w531t4/panelith/ulx3s.kicad_pcb

## KiCad design ulx3s.kicad_pcb (2026-05-25)

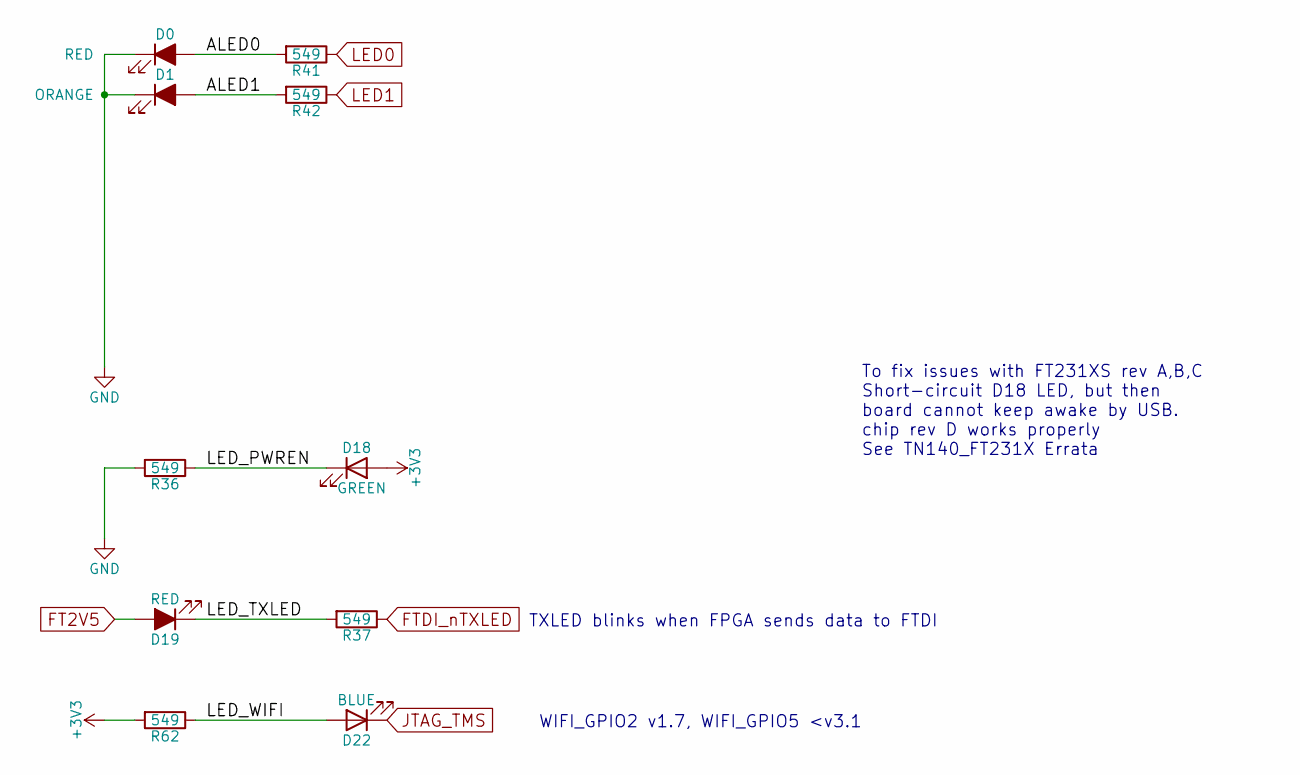
[picture p1: schematic blinkey.kicad_sch, ULX3S]

Parts:
D0: RED; LED_0805_2012Metric; MPN LTST-C170KRKT; Mouser 859-LTST-C170KRKT
D1: ORANGE; LED_0805_2012Metric; MPN LTST-C170KFKT; Mouser 859-LTST-C170KFKT
D18: GREEN; LED_0805_2012Metric; MPN LTST-C170TGKT; Mouser 859-LTST-C170TGKT
D19: RED; LED_0805_2012Metric; MPN LTST-C170KRKT; Mouser_URL www.mouser.com
D22: BLUE; LED_0805_2012Metric; MPN LTST-C170TBKT; Mouser 859-LTST-C170TBKT
R36, R37, R41, R42, R62: 549; R_0603_1608Metric; MPN 13-AC0603FR-07549RLCT-ND; Digikey 13-AC0603FR-07549RLCT-ND

Connections:
+3V3: D18.2 (A), R62.2; also elsewhere on the board
/blinkey/ALED0: D0.2 (A), R41.2
/blinkey/ALED1: D1.2 (A), R42.2
/blinkey/LED_PWREN: D18.1 (K), R36.1
/blinkey/LED_TXLED: D19.1 (K), R37.2
/blinkey/LED_WIFI: D22.2 (A), R62.1
FT2V5: D19.2 (A); also elsewhere on the board
FTDI_nTXLED: R37.1; also elsewhere on the board
GND: D0.1 (K), D1.1 (K), R36.2; also elsewhere on the board
JTAG_TMS: D22.1 (K); also elsewhere on the board
LED0: R41.1; also elsewhere on the board
LED1: R42.1; also elsewhere on the board

Notes on the sheet:
To fix issues with FT231XS rev A,B,C Short-circuit D18 LED, but then board cannot keep awake by USB. chip rev D works properly See TN140_FT231X Errata
TXLED blinks when FPGA sends data to FTDI
WIFI_GPIO2 v1.7, WIFI_GPIO5 <v3.1

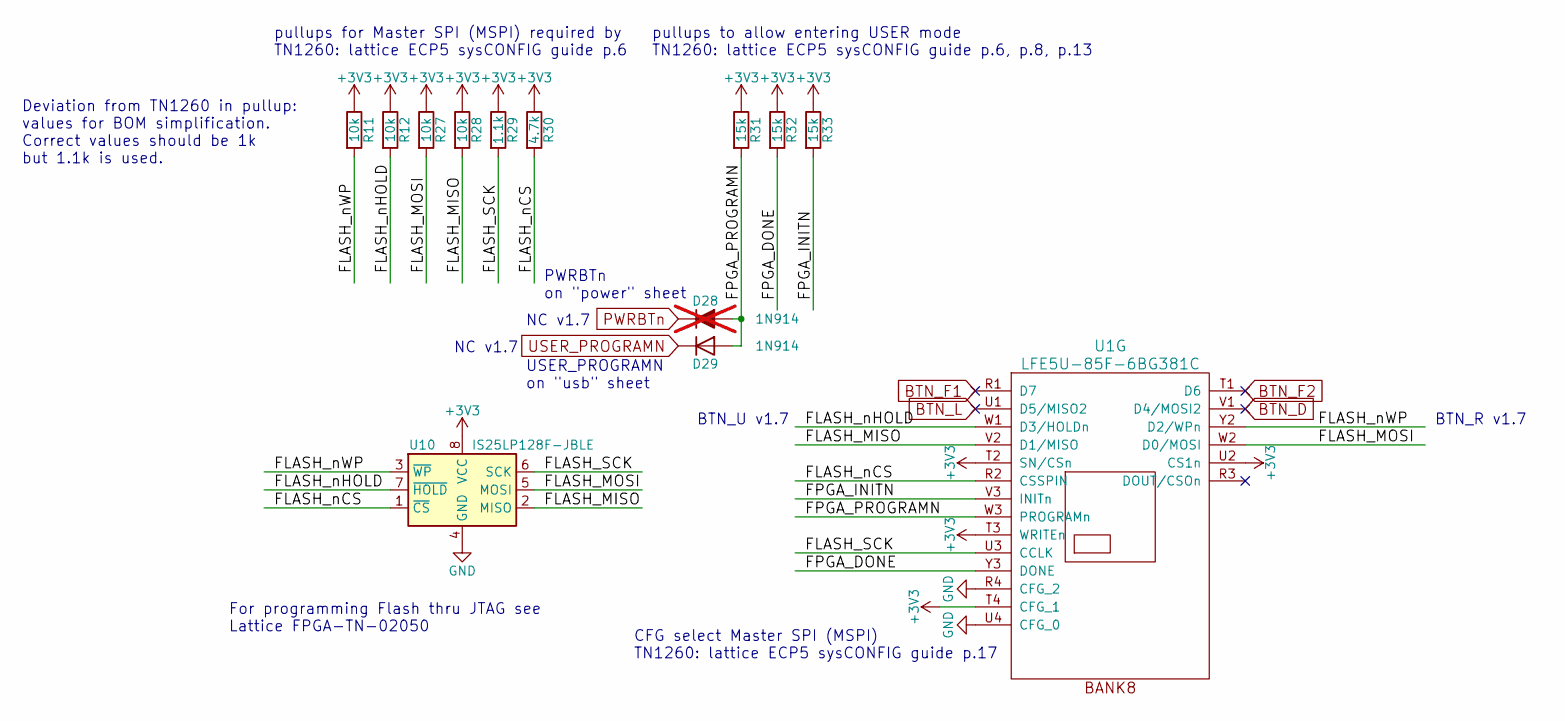
[picture p2: schematic flash.kicad_sch, ULX3S]

Parts:
D28: 1N914; D_SOD-323_HandSoldering; MPN 1N4148WS; Digike_y 1N4148WXTPMSCT-ND; not fitted
D29: 1N914; D_SOD-323_HandSoldering; MPN 1N4148WS; LCSC C258181
R11: 10k; R_0603_1608Metric; MPN RC0603FR-0710KL; Mouser 603-RC0603FR-0710KL
R12, R27, R28: 10k; R_0603_1608Metric; MPN RC0603FR-0710KL; LCSC C15401
R29: 1.1k; R_0603_1608Metric; MPN 13-AC0603FR-071K1LCT-ND; Digikey 13-AC0603FR-071K1LCT-ND
R30: 4.7k; R_0603_1608Metric; MPN 603-RC0603FR-074K7L; LCSC C218056
R31, R32, R33: 15k; R_0603_1608Metric; MPN RC0603FR-0715KL; LCSC C217750
U1: LFE5U-85F-6BG381C; BGA-381_pitch0.8mm_dia0.4mm; MPN LFE5U-85F-6BG381C; LCSC C446029
U10: IS25LP128F-JBLE; SOA008-150-208mil; MPN IS25LP128F-JBLE; Mouser 454-W25Q128JVSIMTR

Connections:
+3V3: R11.1, R12.1, R27.1, R28.1, R29.1, R30.1, R31.1, R32.1, R33.1, U1.T2 (SN/CSn), U1.T3 (WRITEn), U1.T4 (CFG_1), U1.U2 (CS1n), U10.8 (VCC); also elsewhere on the board
/flash/FLASH_MISO: R28.2, U1.V2 (D1/MISO), U10.2 (MISO)
/flash/FLASH_MOSI: R27.2, U1.W2 (D0/MOSI), U10.5 (MOSI)
/flash/FLASH_SCK: R29.2, U1.U3 (CCLK), U10.6 (SCK)
/flash/FLASH_nCS: R30.2, U1.R2 (CSSPIN), U10.1 (~CS)
/flash/FLASH_nHOLD: R12.2, U1.W1 (D3/HOLDn), U10.7 (~HOLD)
/flash/FLASH_nWP: R11.2, U1.Y2 (D2/WPn), U10.3 (~WP)
/flash/FPGA_DONE: R32.2, U1.Y3 (DONE)
/flash/FPGA_INITN: R33.2, U1.V3 (INITn)
/flash/FPGA_PROGRAMN: D28.2 (A), D29.2 (A), R31.2, U1.W3 (PROGRAMn)
AUDIO_L0: U1.E4 (PL17A)
AUDIO_L1: U1.D3 (PL17D)
AUDIO_L3: U1.B3 (PL14D)
AUDIO_R0: U1.A3 (PL14C)
AUDIO_R1: U1.B5 (PL11C)
AUDIO_R2: U1.D5 (PL17B)
AUDIO_R3: U1.C5 (PL11D)
AUDIO_V0: U1.H5 (GR_PCLK7_0)
AUDIO_V1: U1.F2 (PCLKT7_0)
AUDIO_V2: U1.F5 (PL20D)
AUDIO_V3: U1.E5 (PL20C)
BTN_D: U1.V1 (D4/MOSI2)
BTN_F1: U1.R1 (D7)
BTN_F2: U1.T1 (D6)
BTN_L: U1.U1 (D5/MISO2)
BTN_PWRn: D28.1 (K), U1.D6 (PT6B); also elsewhere on the board
GN0: U1.C11 (PCLKC0_0); also elsewhere on the board
GN1: U1.A11 (PCLKC0_1); also elsewhere on the board
GN2: U1.B10 (GR_PCLK0_0); also elsewhere on the board
GN3: U1.C10 (PT58B); also elsewhere on the board
GN4: U1.A8 (PT18B); also elsewhere on the board
GN5: U1.B8 (PT15B); also elsewhere on the board
GN6: U1.C7 (PT11B)
GN7: U1.B6 (PT4B); also elsewhere on the board
GN8: U1.A5 (PL11B); also elsewhere on the board
GN9: U1.B1 (PL35B); also elsewhere on the board
GN10: U1.B4 (PL14B); also elsewhere on the board
GN11: U1.E3 (PL20B); also elsewhere on the board
GN12: U1.F3 (PCLKC7_1); also elsewhere on the board
GN13: U1.G5 (PL41B); also elsewhere on the board
GND: U1.R4 (CFG_2), U1.U4 (CFG_0), U10.4 (GND); also elsewhere on the board
GP0: U1.B11 (PCLKT0_0); also elsewhere on the board
GP1: U1.A10 (PCLKT0_1); also elsewhere on the board
GP2: U1.A9 (GR_PCLK0_1); also elsewhere on the board
GP3: U1.B9 (PT58A); also elsewhere on the board
GP4: U1.A7 (PT18A); also elsewhere on the board
GP5: U1.C8 (PT15A); also elsewhere on the board
GP6: U1.C6 (PT11A); also elsewhere on the board
GP7: U1.A6 (PT4A); also elsewhere on the board
GP8: U1.A4 (PL11A); also elsewhere on the board
GP9: U1.A2 (PL35A); also elsewhere on the board
GP10: U1.C4 (PL14A); also elsewhere on the board
GP11: U1.F4 (PL20A); also elsewhere on the board
GP12: U1.G3 (PCLKT7_1); also elsewhere on the board
GP13: U1.H4 (GR_PCLK7_1); also elsewhere on the board
LED0: U1.B2 (VREF1_7); also elsewhere on the board
LED1: U1.C2 (PL35D); also elsewhere on the board
LED3: U1.D2 (PL38C)
LED4: U1.D1 (PL38B)
LED5: U1.E2 (PCLKC7_0)
LED6: U1.E1 (PL38D)
LED7: U1.H3 (PL41D)
SW1: U1.E8 (PT13A)
SW2: U1.D8 (PT13B)
SW3: U1.D7 (PT9B)
SW4: U1.E7 (PT9A)
USER_PROGRAMN: D29.1 (K); also elsewhere on the board
WIFI_GPIO3: U1.C1 (PL38A); also elsewhere on the board
WIFI_GPIO9: U1.C3 (PL17C); also elsewhere on the board
WIFI_GPIO38: U1.E6 (PT6A); also elsewhere on the board
WIFI_GPIO42: U1.E9 (PT20B); also elsewhere on the board

Notes on the sheet:
PWRBTn on "power" sheet
BTN_U v1.7
For programming Flash thru JTAG see Lattice FPGA-TN-02050
NC v1.7
pullups to allow entering USER mode TN1260: lattice ECP5 sysCONFIG guide p.6, p.8, p.13
CFG select Master SPI (MSPI) TN1260: lattice ECP5 sysCONFIG guide p.17
BTN_R v1.7
USER_PROGRAMN on "usb" sheet
Deviation from TN1260 in pullup: values for BOM simplification. Correct values should be 1k but 1.1k is used.
pullups for Master SPI (MSPI) required by TN1260: lattice ECP5 sysCONFIG guide p.6

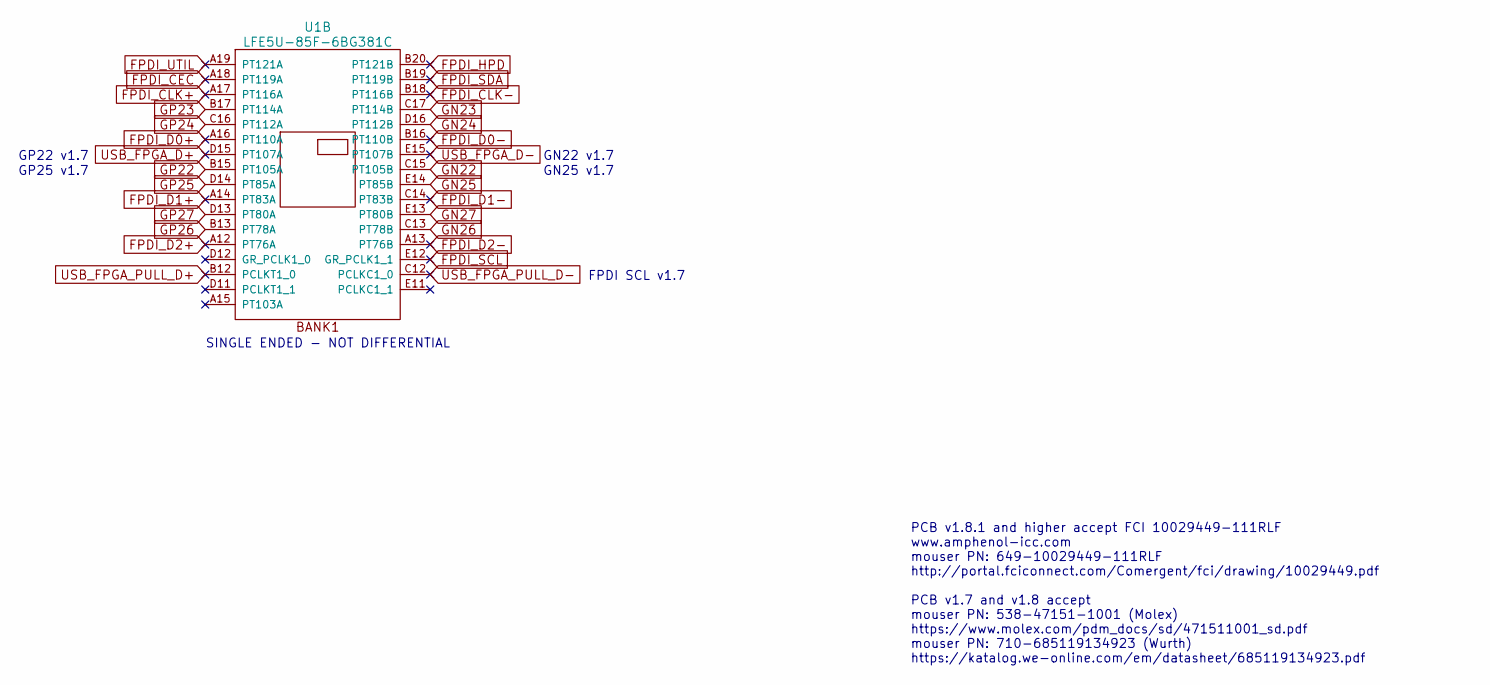
[picture p3: schematic gpdi.kicad_sch, ULX3S]

Parts:
U1: LFE5U-85F-6BG381C; BGA-381_pitch0.8mm_dia0.4mm; MPN LFE5U-85F-6BG381C; Mouser_URL www.mouser.com

Connections:
AUDIO_L0: U1.E4 (PL17A)
AUDIO_L1: U1.D3 (PL17D)
AUDIO_L3: U1.B3 (PL14D)
AUDIO_R0: U1.A3 (PL14C)
AUDIO_R1: U1.B5 (PL11C)
AUDIO_R2: U1.D5 (PL17B)
AUDIO_R3: U1.C5 (PL11D)
AUDIO_V0: U1.H5 (GR_PCLK7_0)
AUDIO_V1: U1.F2 (PCLKT7_0)
AUDIO_V2: U1.F5 (PL20D)
AUDIO_V3: U1.E5 (PL20C)
BTN_PWRn: U1.D6 (PT6B); also elsewhere on the board
FPDI_CEC: U1.A18 (PT119A)
FPDI_CLK+: U1.A17 (PT116A)
FPDI_CLK-: U1.B18 (PT116B)
FPDI_D0+: U1.A16 (PT110A)
FPDI_D0-: U1.B16 (PT110B)
FPDI_D1+: U1.A14 (PT83A)
FPDI_D1-: U1.C14 (PT83B)
FPDI_D2+: U1.A12 (PT76A)
FPDI_D2-: U1.A13 (PT76B)
FPDI_HPD: U1.B20 (PT121B)
FPDI_SCL: U1.E12 (GR_PCLK1_1)
FPDI_SDA: U1.B19 (PT119B)
FPDI_UTIL: U1.A19 (PT121A)
GN0: U1.C11 (PCLKC0_0); also elsewhere on the board
GN1: U1.A11 (PCLKC0_1); also elsewhere on the board
GN2: U1.B10 (GR_PCLK0_0); also elsewhere on the board
GN3: U1.C10 (PT58B); also elsewhere on the board
GN4: U1.A8 (PT18B); also elsewhere on the board
GN5: U1.B8 (PT15B); also elsewhere on the board
GN6: U1.C7 (PT11B)
GN7: U1.B6 (PT4B); also elsewhere on the board
GN8: U1.A5 (PL11B); also elsewhere on the board
GN9: U1.B1 (PL35B); also elsewhere on the board
GN10: U1.B4 (PL14B); also elsewhere on the board
GN11: U1.E3 (PL20B); also elsewhere on the board
GN12: U1.F3 (PCLKC7_1); also elsewhere on the board
GN13: U1.G5 (PL41B); also elsewhere on the board
GN22: U1.C15 (PT105B)
GN23: U1.C17 (PT114B)
GN24: U1.D16 (PT112B)
GN25: U1.E14 (PT85B)
GN26: U1.C13 (PT78B)
GN27: U1.E13 (PT80B)
GP0: U1.B11 (PCLKT0_0); also elsewhere on the board
GP1: U1.A10 (PCLKT0_1); also elsewhere on the board
GP2: U1.A9 (GR_PCLK0_1); also elsewhere on the board
GP3: U1.B9 (PT58A); also elsewhere on the board
GP4: U1.A7 (PT18A); also elsewhere on the board
GP5: U1.C8 (PT15A); also elsewhere on the board
GP6: U1.C6 (PT11A); also elsewhere on the board
GP7: U1.A6 (PT4A); also elsewhere on the board
GP8: U1.A4 (PL11A); also elsewhere on the board
GP9: U1.A2 (PL35A); also elsewhere on the board
GP10: U1.C4 (PL14A); also elsewhere on the board
GP11: U1.F4 (PL20A); also elsewhere on the board
GP12: U1.G3 (PCLKT7_1); also elsewhere on the board
GP13: U1.H4 (GR_PCLK7_1); also elsewhere on the board
GP22: U1.B15 (PT105A)
GP23: U1.B17 (PT114A)
GP24: U1.C16 (PT112A)
GP25: U1.D14 (PT85A)
GP26: U1.B13 (PT78A)
GP27: U1.D13 (PT80A)
LED0: U1.B2 (VREF1_7); also elsewhere on the board
LED1: U1.C2 (PL35D); also elsewhere on the board
LED3: U1.D2 (PL38C)
LED4: U1.D1 (PL38B)
LED5: U1.E2 (PCLKC7_0)
LED6: U1.E1 (PL38D)
LED7: U1.H3 (PL41D)
SW1: U1.E8 (PT13A)
SW2: U1.D8 (PT13B)
SW3: U1.D7 (PT9B)
SW4: U1.E7 (PT9A)
USB_FPGA_D+: U1.D15 (PT107A); also elsewhere on the board
USB_FPGA_D-: U1.E15 (PT107B); also elsewhere on the board
USB_FPGA_PULL_D+: U1.B12 (PCLKT1_0)
USB_FPGA_PULL_D-: U1.C12 (PCLKC1_0)
WIFI_GPIO3: U1.C1 (PL38A); also elsewhere on the board
WIFI_GPIO9: U1.C3 (PL17C); also elsewhere on the board
WIFI_GPIO38: U1.E6 (PT6A); also elsewhere on the board
WIFI_GPIO42: U1.E9 (PT20B); also elsewhere on the board

Notes on the sheet:
PCB v1.8.1 and higher accept FCI 10029449-111RLF www.amphenol-icc.com mouser PN: 649-10029449-111RLF http://portal.fciconnect.com/Comergent/fci/drawing/10029449.pdf PCB v1.7 and v1.8 accept mouser PN: 538-47151-1001 (Molex) https://www.molex.com/pdm_docs/sd/471511001_sd.pdf mouser PN: 710-685119134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
GN22 v1.7
GN25 v1.7
GP25 v1.7
FPDI SCL v1.7
SINGLE ENDED - NOT DIFFERENTIAL
GP22 v1.7

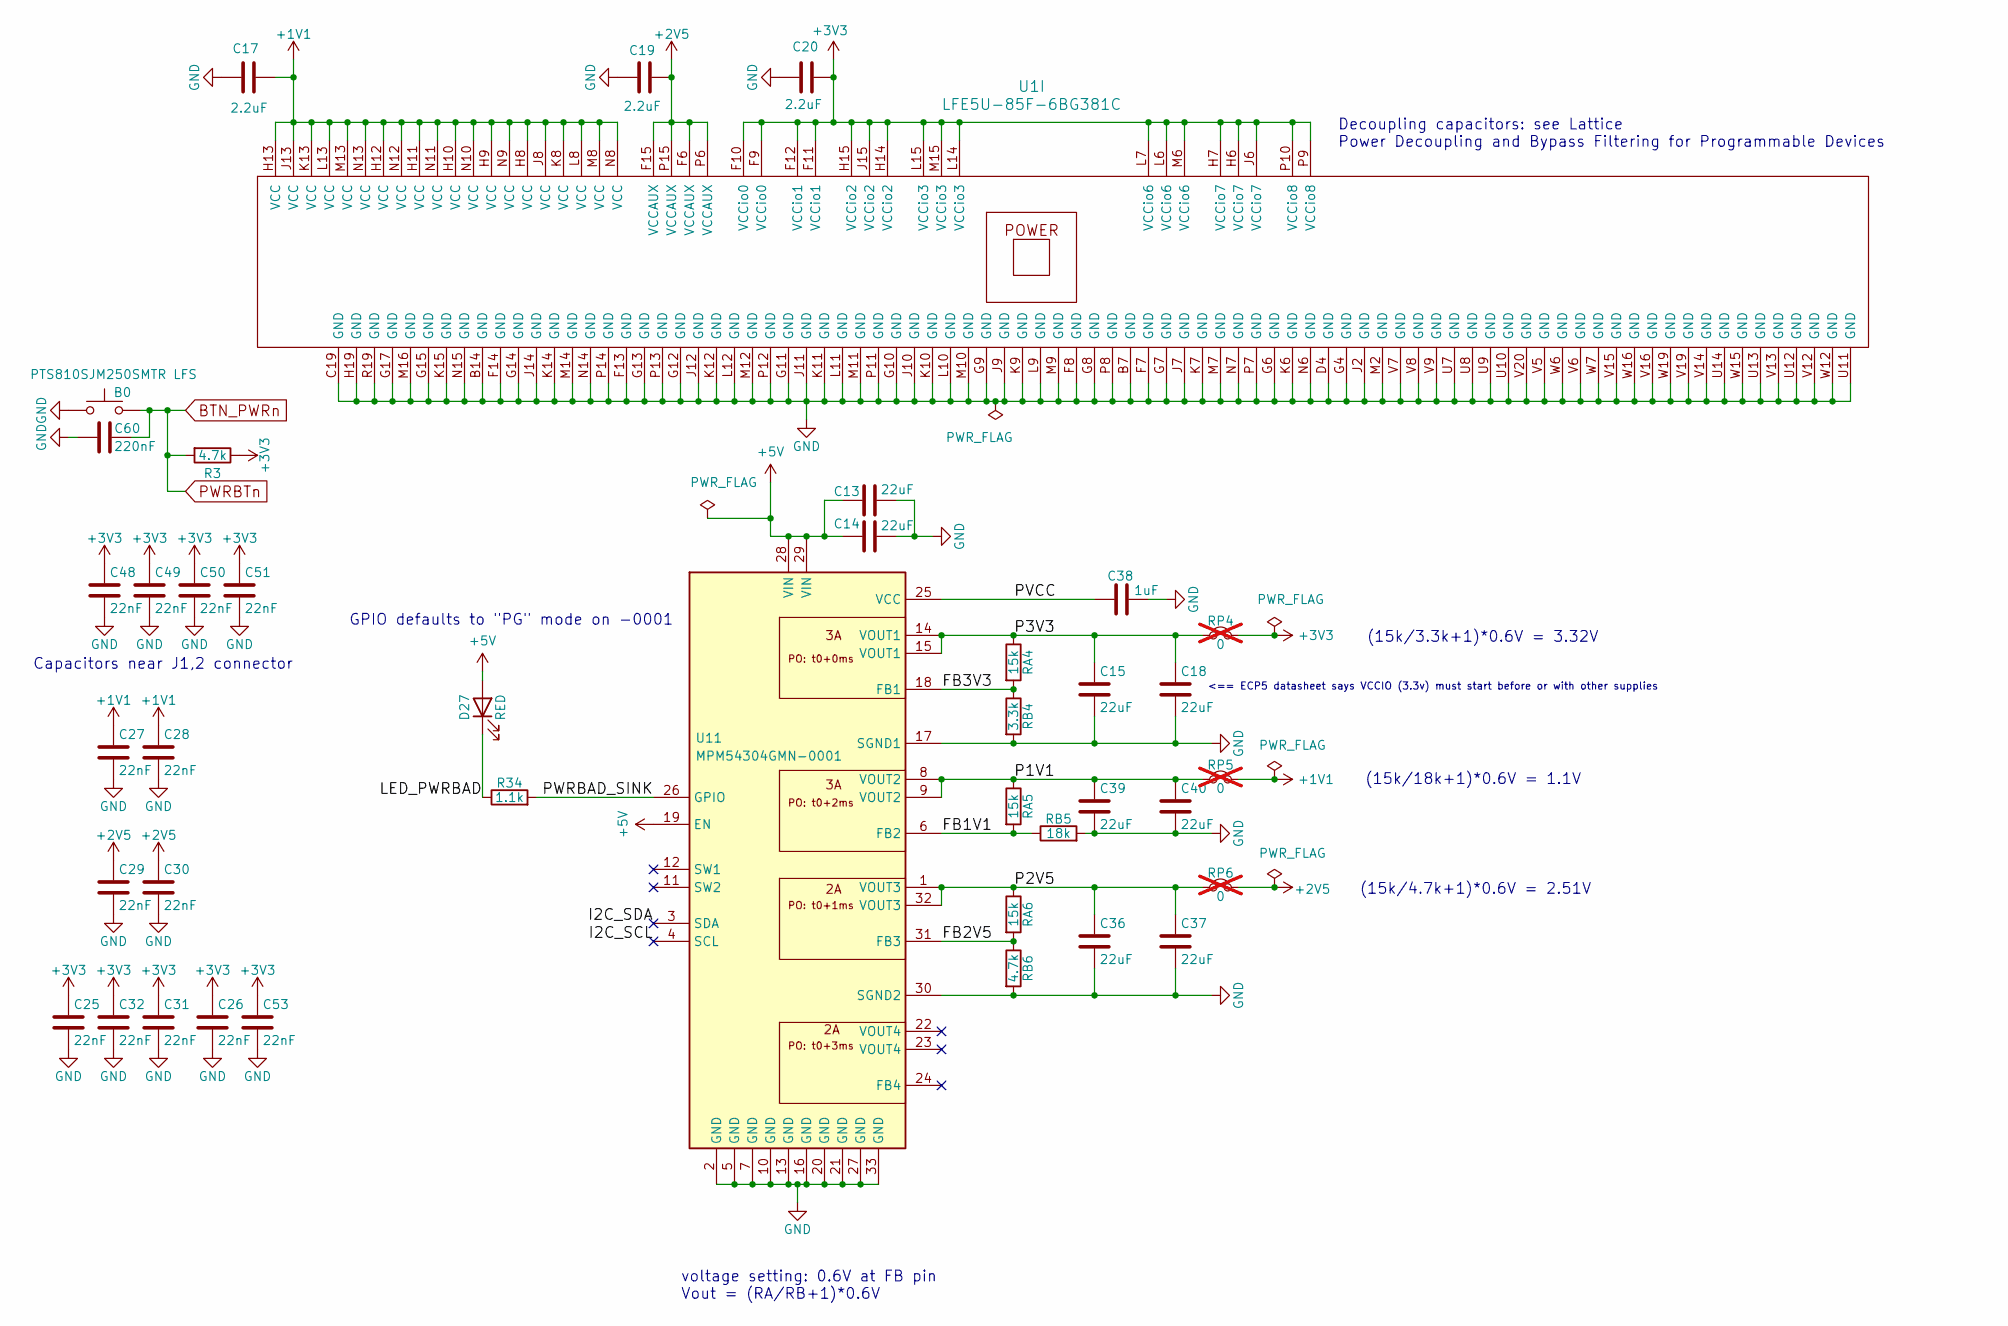
[picture p4: schematic power.kicad_sch, ULX3S]

Parts:
B0: PTS810SJM250SMTR LFS; PTS810_CNK; MPN 611-PTS810SJM250SMTR; Digikey CKN10502CT-ND
C13, C14: 22uF; C_0805_2012Metric; MPN 603-CC805MKX5R6BB226; Mouser 81-GRM21BR61A226ME1L
C15, C18, C36, C37, C39, C40: 22uF; C_0805_2012Metric; MPN 603-CC805MKX5R6BB226; Digikey 311-1900-1-ND
C17, C19, C20: 2.2uF; C_0805_2012Metric; MPN CC0805MRX5R6BB225; LCSC C87995
C25: 22nF; C_0603_1608Metric; MPN CC0603JRX7R8BB223; Mouser 603-CC603KRX7R7BB223
C26, C27, C28, C29, C30, C31, C32, C48, C49, C50, C51, C53: 22nF; C_0603_1608Metric; MPN CC0603JRX7R8BB223; LCSC C107137
C38: 1uF; C_0805_2012Metric; MPN 603-CC805KRX5R6BB105; Digikey 311-3423-1-ND
C60: 220nF; C_0603_1608Metric; MPN CC0603KRX7R8BB224; LCSC C326805
D27: RED; LED_0805_2012Metric; MPN LTST-C170KRKT; Mouser_URL www.mouser.com
R3: 4.7k; R_0603_1608Metric; MPN 603-RC0603FR-074K7L; LCSC C218056
R34: 1.1k; R_0603_1608Metric; MPN 13-AC0603FR-071K1LCT-ND; Digikey 13-AC0603FR-071K1LCT-ND
RA4, RA5, RA6: 15k; R_0603_1608Metric; MPN RC0603FR-0715KL; LCSC C217750
RB4: 3.3k; R_0603_1608Metric; MPN RT0603FRE073K3L; Mouser 603-RC0603FR-073K3L
RB5: 18k; R_0603_1608Metric; MPN RC0603FR-1018KL; Mouser 71-CRCW060318K0FKEAC
RB6: 4.7k; R_0603_1608Metric; MPN 603-RC0603FR-074K7L; LCSC C218056
RP4, RP5, RP6: 0; R_0805_2012Metric_Pad1.20x1.40mm_HandSolder; MPN 603-RC0805JR-070RL; Mouser_URL www.mouser.com; not fitted
U1: LFE5U-85F-6BG381C; BGA-381_pitch0.8mm_dia0.4mm; MPN LFE5U-85F-6BG381C; LCSC C446029
U11: MPM54304GMN-0001; MPM54304GMN0001; Manufacturer_Part_Number MPM54304GMN-0001; Mouser Part Number 946-MPM54304GMN-0001

Connections:
+1V1: C17.2, C27.1, C28.1, RP5.2, U1.H8 (VCC), U1.H9 (VCC), U1.H10 (VCC), U1.H11 (VCC), U1.H12 (VCC), U1.H13 (VCC), U1.J8 (VCC), U1.J13 (VCC), U1.K8 (VCC), U1.K13 (VCC), U1.L8 (VCC), U1.L13 (VCC), U1.M8 (VCC), U1.M13 (VCC), U1.N8 (VCC), U1.N9 (VCC), U1.N10 (VCC), U1.N11 (VCC), U1.N12 (VCC), U1.N13 (VCC)
+2V5: C19.1, C29.1, C30.1, RP6.2, U1.F6 (VCCAUX), U1.F15 (VCCAUX), U1.P6 (VCCAUX), U1.P15 (VCCAUX)
+3V3: C20.2, C25.1, C26.1, C31.1, C32.1, C48.1, C49.1, C50.1, C51.1, C53.1, R3.1, RP4.2, U1.F9 (VCCio0), U1.F10 (VCCio0), U1.F11 (VCCio1), U1.F12 (VCCio1), U1.H6 (VCCio7), U1.H7 (VCCio7), U1.H14 (VCCio2), U1.H15 (VCCio2), U1.J6 (VCCio7), U1.J15 (VCCio2), U1.L6 (VCCio6), U1.L7 (VCCio6), U1.L14 (VCCio3), U1.L15 (VCCio3), U1.M6 (VCCio6), U1.M15 (VCCio3), U1.P9 (VCCio8), U1.P10 (VCCio8); also elsewhere on the board
+5V: C13.1, C14.1, D27.2 (A), U11.19 (EN), U11.28 (VIN), U11.29 (VIN); also elsewhere on the board
/power/FB1V1: RA5.2, RB5.1, U11.6 (FB2)
/power/FB2V5: RA6.2, RB6.1, U11.31 (FB3)
/power/FB3V3: RA4.2, RB4.1, U11.18 (FB1)
/power/I2C_SCL: U11.4 (SCL)
/power/I2C_SDA: U11.3 (SDA)
/power/LED_PWRBAD: D27.1 (K), R34.1
/power/P1V1: C39.1, C40.1, RA5.1, RP5.1, U11.8 (VOUT2), U11.9 (VOUT2)
/power/P2V5: C36.1, C37.1, RA6.1, RP6.1, U11.1 (VOUT3), U11.32 (VOUT3)
/power/P3V3: C15.1, C18.1, RA4.1, RP4.1, U11.14 (VOUT1), U11.15 (VOUT1)
/power/PVCC: C38.1, U11.25 (VCC)
/power/PWRBAD_SINK: R34.2, U11.26 (GPIO)
AUDIO_L0: U1.E4 (PL17A)
AUDIO_L1: U1.D3 (PL17D)
AUDIO_L3: U1.B3 (PL14D)
AUDIO_R0: U1.A3 (PL14C)
AUDIO_R1: U1.B5 (PL11C)
AUDIO_R2: U1.D5 (PL17B)
AUDIO_R3: U1.C5 (PL11D)
AUDIO_V0: U1.H5 (GR_PCLK7_0)
AUDIO_V1: U1.F2 (PCLKT7_0)
AUDIO_V2: U1.F5 (PL20D)
AUDIO_V3: U1.E5 (PL20C)
BTN_PWRn: B0.1, C60.1, R3.2, U1.D6 (PT6B); also elsewhere on the board
GN0: U1.C11 (PCLKC0_0); also elsewhere on the board
GN1: U1.A11 (PCLKC0_1); also elsewhere on the board
GN2: U1.B10 (GR_PCLK0_0); also elsewhere on the board
GN3: U1.C10 (PT58B); also elsewhere on the board
GN4: U1.A8 (PT18B); also elsewhere on the board
GN5: U1.B8 (PT15B); also elsewhere on the board
GN6: U1.C7 (PT11B)
GN7: U1.B6 (PT4B); also elsewhere on the board
GN8: U1.A5 (PL11B); also elsewhere on the board
GN9: U1.B1 (PL35B); also elsewhere on the board
GN10: U1.B4 (PL14B); also elsewhere on the board
GN11: U1.E3 (PL20B); also elsewhere on the board
GN12: U1.F3 (PCLKC7_1); also elsewhere on the board
GN13: U1.G5 (PL41B); also elsewhere on the board
GND: B0.2, C13.2, C14.2, C15.2, C17.1, C18.2, C19.2, C20.1, C25.2, C26.2, C27.2, C28.2, C29.2, C30.2, C31.2, C32.2, C36.2, C37.2, C38.2, C39.2, C40.2, C48.2, C49.2, C50.2, C51.2, C53.2, C60.2, RB4.2, RB5.2, RB6.2, U1.B7 (GND), U1.B14 (GND), U1.C19 (GND), U1.D4 (GND), U1.F7 (GND), U1.F8 (GND), U1.F13 (GND), U1.F14 (GND), U1.G4 (GND), U1.G6 (GND), U1.G7 (GND), U1.G8 (GND), U1.G9 (GND), U1.G10 (GND), U1.G11 (GND), U1.G12 (GND), U1.G13 (GND), U1.G14 (GND), U1.G15 (GND), U1.G17 (GND), U1.H19 (GND), U1.J2 (GND), U1.J7 (GND), U1.J9 (GND), U1.J10 (GND), U1.J11 (GND), U1.J12 (GND), U1.J14 (GND), U1.K6 (GND), U1.K7 (GND), U1.K9 (GND), U1.K10 (GND), U1.K11 (GND), U1.K12 (GND), U1.K14 (GND), U1.K15 (GND), U1.L9 (GND), U1.L10 (GND), U1.L11 (GND), U1.L12 (GND), U1.M2 (GND), U1.M7 (GND), U1.M9 (GND), U1.M10 (GND), U1.M11 (GND), U1.M12 (GND), U1.M14 (GND), U1.M16 (GND), U1.N6 (GND), U1.N7 (GND), U1.N14 (GND), U1.N15 (GND), U1.P7 (GND), U1.P8 (GND), U1.P11 (GND), U1.P12 (GND), U1.P13 (GND), U1.P14 (GND), U1.R19 (GND), U1.U7 (GND), U1.U8 (GND), U1.U9 (GND), U1.U10 (GND), U1.U11 (GND), U1.U12 (GND), U1.U13 (GND), U1.U14 (GND), U1.V5 (GND), U1.V6 (GND), U1.V7 (GND), U1.V8 (GND), U1.V9 (GND), U1.V12 (GND), U1.V13 (GND), U1.V14 (GND), U1.V15 (GND), U1.V16 (GND), U1.V19 (GND), U1.V20 (GND), U1.W6 (GND), U1.W7 (GND), U1.W12 (GND), U1.W15 (GND), U1.W16 (GND), U1.W19 (GND), U11.2 (GND), U11.5 (GND), U11.7 (GND), U11.10 (GND), U11.13 (GND), U11.16 (GND), U11.17 (SGND1), U11.20 (GND), U11.21 (GND), U11.27 (GND), U11.30 (SGND2), U11.33 (GND); also elsewhere on the board
GP0: U1.B11 (PCLKT0_0); also elsewhere on the board
GP1: U1.A10 (PCLKT0_1); also elsewhere on the board
GP2: U1.A9 (GR_PCLK0_1); also elsewhere on the board
GP3: U1.B9 (PT58A); also elsewhere on the board
GP4: U1.A7 (PT18A); also elsewhere on the board
GP5: U1.C8 (PT15A); also elsewhere on the board
GP6: U1.C6 (PT11A); also elsewhere on the board
GP7: U1.A6 (PT4A); also elsewhere on the board
GP8: U1.A4 (PL11A); also elsewhere on the board
GP9: U1.A2 (PL35A); also elsewhere on the board
GP10: U1.C4 (PL14A); also elsewhere on the board
GP11: U1.F4 (PL20A); also elsewhere on the board
GP12: U1.G3 (PCLKT7_1); also elsewhere on the board
GP13: U1.H4 (GR_PCLK7_1); also elsewhere on the board
LED0: U1.B2 (VREF1_7); also elsewhere on the board
LED1: U1.C2 (PL35D); also elsewhere on the board
LED3: U1.D2 (PL38C)
LED4: U1.D1 (PL38B)
LED5: U1.E2 (PCLKC7_0)
LED6: U1.E1 (PL38D)
LED7: U1.H3 (PL41D)
SW1: U1.E8 (PT13A)
SW2: U1.D8 (PT13B)
SW3: U1.D7 (PT9B)
SW4: U1.E7 (PT9A)
WIFI_GPIO3: U1.C1 (PL38A); also elsewhere on the board
WIFI_GPIO9: U1.C3 (PL17C); also elsewhere on the board
WIFI_GPIO38: U1.E6 (PT6A); also elsewhere on the board
WIFI_GPIO42: U1.E9 (PT20B); also elsewhere on the board

Notes on the sheet:
GPIO defaults to "PG" mode on -0001
(15k/4.7k+1)*0.6V = 2.51V
<== ECP5 datasheet says VCCIO (3.3v) must start before or with other supplies
(15k/18k+1)*0.6V = 1.1V
Decoupling capacitors: see Lattice Power Decoupling and Bypass Filtering for Programmable Devices
(15k/3.3k+1)*0.6V = 3.32V
Capacitors near J1,2 connector
voltage setting: 0.6V at FB pin Vout = (RA/RB+1)*0.6V

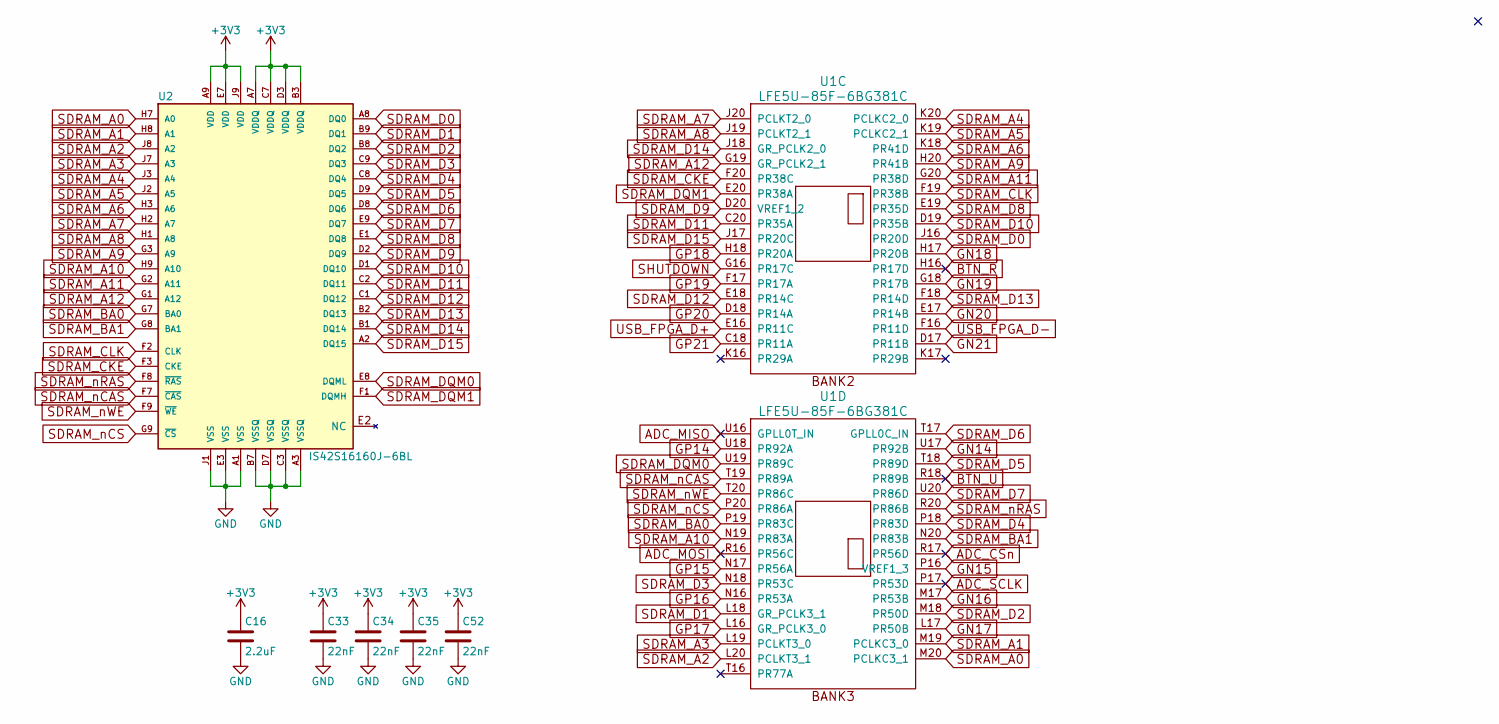
[picture p5: schematic ram.kicad_sch, ULX3S]

Parts:
C16: 2.2uF; C_0805_2012Metric; MPN CC0805MRX5R6BB225; LCSC C87995
C33, C34, C35, C52: 22nF; C_0603_1608Metric; MPN CC0603JRX7R8BB223; LCSC C107137
U1: LFE5U-85F-6BG381C; BGA-381_pitch0.8mm_dia0.4mm; MPN LFE5U-85F-6BG381C; LCSC C446029
U2: IS42S16160J-6BL; BGA54C80P9X9_800X800X120; MPN 870-42S16160J6BL; Mouser 870-IS42S16160G7TLTR

Connections:
+3V3: C16.1, C33.1, C34.1, C35.1, C52.1, U2.A7 (VDDQ), U2.A9 (VDD), U2.B3 (VDDQ), U2.C7 (VDDQ), U2.D3 (VDDQ), U2.E7 (VDD), U2.J9 (VDD); also elsewhere on the board
ADC_CSn: U1.R17 (PR56D)
ADC_MISO: U1.U16 (GPLL0T_IN)
ADC_MOSI: U1.R16 (PR56C)
ADC_SCLK: U1.P17 (PR53D)
AUDIO_L0: U1.E4 (PL17A)
AUDIO_L1: U1.D3 (PL17D)
AUDIO_L3: U1.B3 (PL14D)
AUDIO_R0: U1.A3 (PL14C)
AUDIO_R1: U1.B5 (PL11C)
AUDIO_R2: U1.D5 (PL17B)
AUDIO_R3: U1.C5 (PL11D)
AUDIO_V0: U1.H5 (GR_PCLK7_0)
AUDIO_V1: U1.F2 (PCLKT7_0)
AUDIO_V2: U1.F5 (PL20D)
AUDIO_V3: U1.E5 (PL20C)
BTN_PWRn: U1.D6 (PT6B); also elsewhere on the board
BTN_R: U1.H16 (PR17D)
BTN_U: U1.R18 (PR89B)
GN0: U1.C11 (PCLKC0_0); also elsewhere on the board
GN1: U1.A11 (PCLKC0_1); also elsewhere on the board
GN2: U1.B10 (GR_PCLK0_0); also elsewhere on the board
GN3: U1.C10 (PT58B); also elsewhere on the board
GN4: U1.A8 (PT18B); also elsewhere on the board
GN5: U1.B8 (PT15B); also elsewhere on the board
GN6: U1.C7 (PT11B)
GN7: U1.B6 (PT4B); also elsewhere on the board
GN8: U1.A5 (PL11B); also elsewhere on the board
GN9: U1.B1 (PL35B); also elsewhere on the board
GN10: U1.B4 (PL14B); also elsewhere on the board
GN11: U1.E3 (PL20B); also elsewhere on the board
GN12: U1.F3 (PCLKC7_1); also elsewhere on the board
GN13: U1.G5 (PL41B); also elsewhere on the board
GN14: U1.U17 (PR92B)
GN15: U1.P16 (VREF1_3)
GN16: U1.M17 (PR53B)
GN17: U1.L17 (PR50B)
GN18: U1.H17 (PR20B)
GN19: U1.G18 (PR17B)
GN20: U1.E17 (PR14B)
GN21: U1.D17 (PR11B)
GND: C16.2, C33.2, C34.2, C35.2, C52.2, U2.A1 (VSS), U2.A3 (VSSQ), U2.B7 (VSSQ), U2.C3 (VSSQ), U2.D7 (VSSQ), U2.E3 (VSS), U2.J1 (VSS); also elsewhere on the board
GP0: U1.B11 (PCLKT0_0); also elsewhere on the board
GP1: U1.A10 (PCLKT0_1); also elsewhere on the board
GP2: U1.A9 (GR_PCLK0_1); also elsewhere on the board
GP3: U1.B9 (PT58A); also elsewhere on the board
GP4: U1.A7 (PT18A); also elsewhere on the board
GP5: U1.C8 (PT15A); also elsewhere on the board
GP6: U1.C6 (PT11A); also elsewhere on the board
GP7: U1.A6 (PT4A); also elsewhere on the board
GP8: U1.A4 (PL11A); also elsewhere on the board
GP9: U1.A2 (PL35A); also elsewhere on the board
GP10: U1.C4 (PL14A); also elsewhere on the board
GP11: U1.F4 (PL20A); also elsewhere on the board
GP12: U1.G3 (PCLKT7_1); also elsewhere on the board
GP13: U1.H4 (GR_PCLK7_1); also elsewhere on the board
GP14: U1.U18 (PR92A)
GP15: U1.N17 (PR56A)
GP16: U1.N16 (PR53A)
GP17: U1.L16 (GR_PCLK3_0)
GP18: U1.H18 (PR20A)
GP19: U1.F17 (PR17A)
GP20: U1.D18 (PR14A)
GP21: U1.C18 (PR11A)
LED0: U1.B2 (VREF1_7); also elsewhere on the board
LED1: U1.C2 (PL35D); also elsewhere on the board
LED3: U1.D2 (PL38C)
LED4: U1.D1 (PL38B)
LED5: U1.E2 (PCLKC7_0)
LED6: U1.E1 (PL38D)
LED7: U1.H3 (PL41D)
SDRAM_A0: U1.M20 (PCLKC3_1), U2.H7 (A0)
SDRAM_A1: U1.M19 (PCLKC3_0), U2.H8 (A1)
SDRAM_A2: U1.L20 (PCLKT3_1), U2.J8 (A2)
SDRAM_A3: U1.L19 (PCLKT3_0), U2.J7 (A3)
SDRAM_A4: U1.K20 (PCLKC2_0), U2.J3 (A4)
SDRAM_A5: U1.K19 (PCLKC2_1), U2.J2 (A5)
SDRAM_A6: U1.K18 (PR41D), U2.H3 (A6)
SDRAM_A7: U1.J20 (PCLKT2_0), U2.H2 (A7)
SDRAM_A8: U1.J19 (PCLKT2_1), U2.H1 (A8)
SDRAM_A9: U1.H20 (PR41B), U2.G3 (A9)
SDRAM_A10: U1.N19 (PR83A), U2.H9 (A10)
SDRAM_A11: U1.G20 (PR38D), U2.G2 (A11)
SDRAM_A12: U1.G19 (GR_PCLK2_1), U2.G1 (A12)
SDRAM_BA0: U1.P19 (PR83C), U2.G7 (BA0)
SDRAM_BA1: U1.N20 (PR83B), U2.G8 (BA1)
SDRAM_CKE: U1.F20 (PR38C), U2.F3 (CKE)
SDRAM_CLK: U1.F19 (PR38B), U2.F2 (CLK)
SDRAM_D0: U1.J16 (PR20D), U2.A8 (DQ0)
SDRAM_D1: U1.L18 (GR_PCLK3_1), U2.B9 (DQ1)
SDRAM_D2: U1.M18 (PR50D), U2.B8 (DQ2)
SDRAM_D3: U1.N18 (PR53C), U2.C9 (DQ3)
SDRAM_D4: U1.P18 (PR83D), U2.C8 (DQ4)
SDRAM_D5: U1.T18 (PR89D), U2.D9 (DQ5)
SDRAM_D6: U1.T17 (GPLL0C_IN), U2.D8 (DQ6)
SDRAM_D7: U1.U20 (PR86D), U2.E9 (DQ7)
SDRAM_D8: U1.E19 (PR35D), U2.E1 (DQ8)
SDRAM_D9: U1.D20 (VREF1_2), U2.D2 (DQ9)
SDRAM_D10: U1.D19 (PR35B), U2.D1 (DQ10)
SDRAM_D11: U1.C20 (PR35A), U2.C2 (DQ11)
SDRAM_D12: U1.E18 (PR14C), U2.C1 (DQ12)
SDRAM_D13: U1.F18 (PR14D), U2.B2 (DQ13)
SDRAM_D14: U1.J18 (GR_PCLK2_0), U2.B1 (DQ14)
SDRAM_D15: U1.J17 (PR20C), U2.A2 (DQ15)
SDRAM_DQM0: U1.U19 (PR89C), U2.E8 (DQML)
SDRAM_DQM1: U1.E20 (PR38A), U2.F1 (DQMH)
SDRAM_nCAS: U1.T19 (PR89A), U2.F7 (~CAS)
SDRAM_nCS: U1.P20 (PR86A), U2.G9 (~CS)
SDRAM_nRAS: U1.R20 (PR86B), U2.F8 (~RAS)
SDRAM_nWE: U1.T20 (PR86C), U2.F9 (~WE)
SHUTDOWN: U1.G16 (PR17C)
SW1: U1.E8 (PT13A)
SW2: U1.D8 (PT13B)
SW3: U1.D7 (PT9B)
SW4: U1.E7 (PT9A)
USB_FPGA_D+: U1.E16 (PR11C); also elsewhere on the board
USB_FPGA_D-: U1.F16 (PR11D); also elsewhere on the board
WIFI_GPIO3: U1.C1 (PL38A); also elsewhere on the board
WIFI_GPIO9: U1.C3 (PL17C); also elsewhere on the board
WIFI_GPIO38: U1.E6 (PT6A); also elsewhere on the board
WIFI_GPIO42: U1.E9 (PT20B); also elsewhere on the board

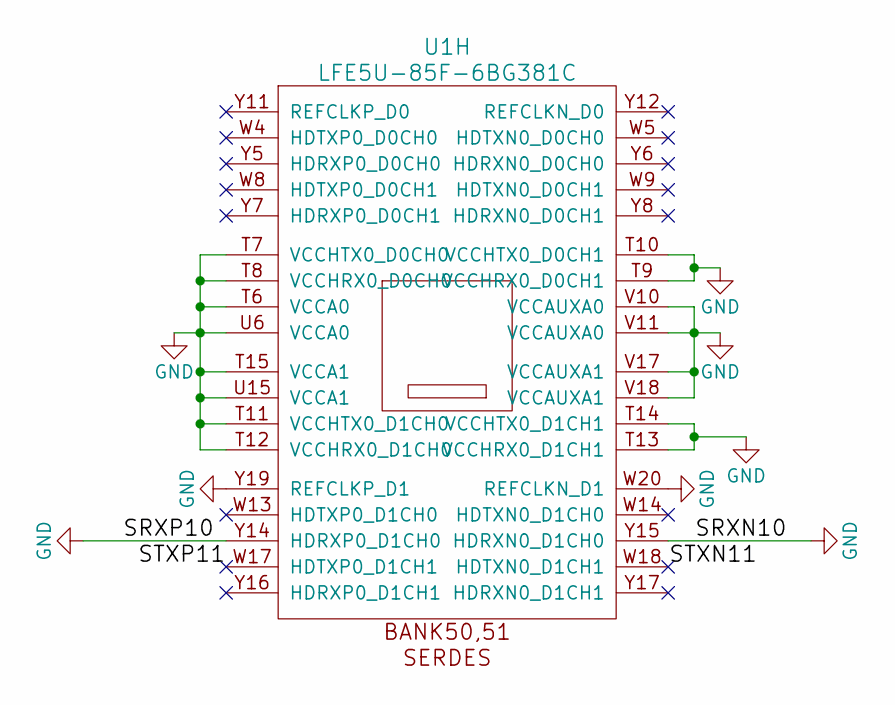
[picture p6: schematic serdes.kicad_sch, ULX3S]

Parts:
U1: LFE5U-85F-6BG381C; BGA-381_pitch0.8mm_dia0.4mm; MPN LFE5U-85F-6BG381C; Mouser 842-LFE5U85F6BG381C

Connections:
/serdes/STXN11: U1.W18 (HDTXN0_D1CH1)
/serdes/STXP11: U1.W17 (HDTXP0_D1CH1)
AUDIO_L0: U1.E4 (PL17A)
AUDIO_L1: U1.D3 (PL17D)
AUDIO_L3: U1.B3 (PL14D)
AUDIO_R0: U1.A3 (PL14C)
AUDIO_R1: U1.B5 (PL11C)
AUDIO_R2: U1.D5 (PL17B)
AUDIO_R3: U1.C5 (PL11D)
AUDIO_V0: U1.H5 (GR_PCLK7_0)
AUDIO_V1: U1.F2 (PCLKT7_0)
AUDIO_V2: U1.F5 (PL20D)
AUDIO_V3: U1.E5 (PL20C)
BTN_PWRn: U1.D6 (PT6B); also elsewhere on the board
GN0: U1.C11 (PCLKC0_0); also elsewhere on the board
GN1: U1.A11 (PCLKC0_1); also elsewhere on the board
GN2: U1.B10 (GR_PCLK0_0); also elsewhere on the board
GN3: U1.C10 (PT58B); also elsewhere on the board
GN4: U1.A8 (PT18B); also elsewhere on the board
GN5: U1.B8 (PT15B); also elsewhere on the board
GN6: U1.C7 (PT11B)
GN7: U1.B6 (PT4B); also elsewhere on the board
GN8: U1.A5 (PL11B); also elsewhere on the board
GN9: U1.B1 (PL35B); also elsewhere on the board
GN10: U1.B4 (PL14B); also elsewhere on the board
GN11: U1.E3 (PL20B); also elsewhere on the board
GN12: U1.F3 (PCLKC7_1); also elsewhere on the board
GN13: U1.G5 (PL41B); also elsewhere on the board
GND: U1.T6 (VCCA0), U1.T7 (VCCHTX0_D0CH0), U1.T8 (VCCHRX0_D0CH0), U1.T9 (VCCHRX0_D0CH1), U1.T10 (VCCHTX0_D0CH1), U1.T11 (VCCHTX0_D1CH0), U1.T12 (VCCHRX0_D1CH0), U1.T13 (VCCHRX0_D1CH1), U1.T14 (VCCHTX0_D1CH1), U1.T15 (VCCA1), U1.U6 (VCCA0), U1.U15 (VCCA1), U1.V10 (VCCAUXA0), U1.V11 (VCCAUXA0), U1.V17 (VCCAUXA1), U1.V18 (VCCAUXA1), U1.W20 (REFCLKN_D1), U1.Y14 (HDRXP0_D1CH0), U1.Y15 (HDRXN0_D1CH0), U1.Y19 (REFCLKP_D1); also elsewhere on the board
GP0: U1.B11 (PCLKT0_0); also elsewhere on the board
GP1: U1.A10 (PCLKT0_1); also elsewhere on the board
GP2: U1.A9 (GR_PCLK0_1); also elsewhere on the board
GP3: U1.B9 (PT58A); also elsewhere on the board
GP4: U1.A7 (PT18A); also elsewhere on the board
GP5: U1.C8 (PT15A); also elsewhere on the board
GP6: U1.C6 (PT11A); also elsewhere on the board
GP7: U1.A6 (PT4A); also elsewhere on the board
GP8: U1.A4 (PL11A); also elsewhere on the board
GP9: U1.A2 (PL35A); also elsewhere on the board
GP10: U1.C4 (PL14A); also elsewhere on the board
GP11: U1.F4 (PL20A); also elsewhere on the board
GP12: U1.G3 (PCLKT7_1); also elsewhere on the board
GP13: U1.H4 (GR_PCLK7_1); also elsewhere on the board
LED0: U1.B2 (VREF1_7); also elsewhere on the board
LED1: U1.C2 (PL35D); also elsewhere on the board
LED3: U1.D2 (PL38C)
LED4: U1.D1 (PL38B)
LED5: U1.E2 (PCLKC7_0)
LED6: U1.E1 (PL38D)
LED7: U1.H3 (PL41D)
SW1: U1.E8 (PT13A)
SW2: U1.D8 (PT13B)
SW3: U1.D7 (PT9B)
SW4: U1.E7 (PT9A)
WIFI_GPIO3: U1.C1 (PL38A); also elsewhere on the board
WIFI_GPIO9: U1.C3 (PL17C); also elsewhere on the board
WIFI_GPIO38: U1.E6 (PT6A); also elsewhere on the board
WIFI_GPIO42: U1.E9 (PT20B); also elsewhere on the board
