w531t4/panelith/ulx3s.kicad_pcb

## KiCad design ulx3s.kicad_pcb (continued)

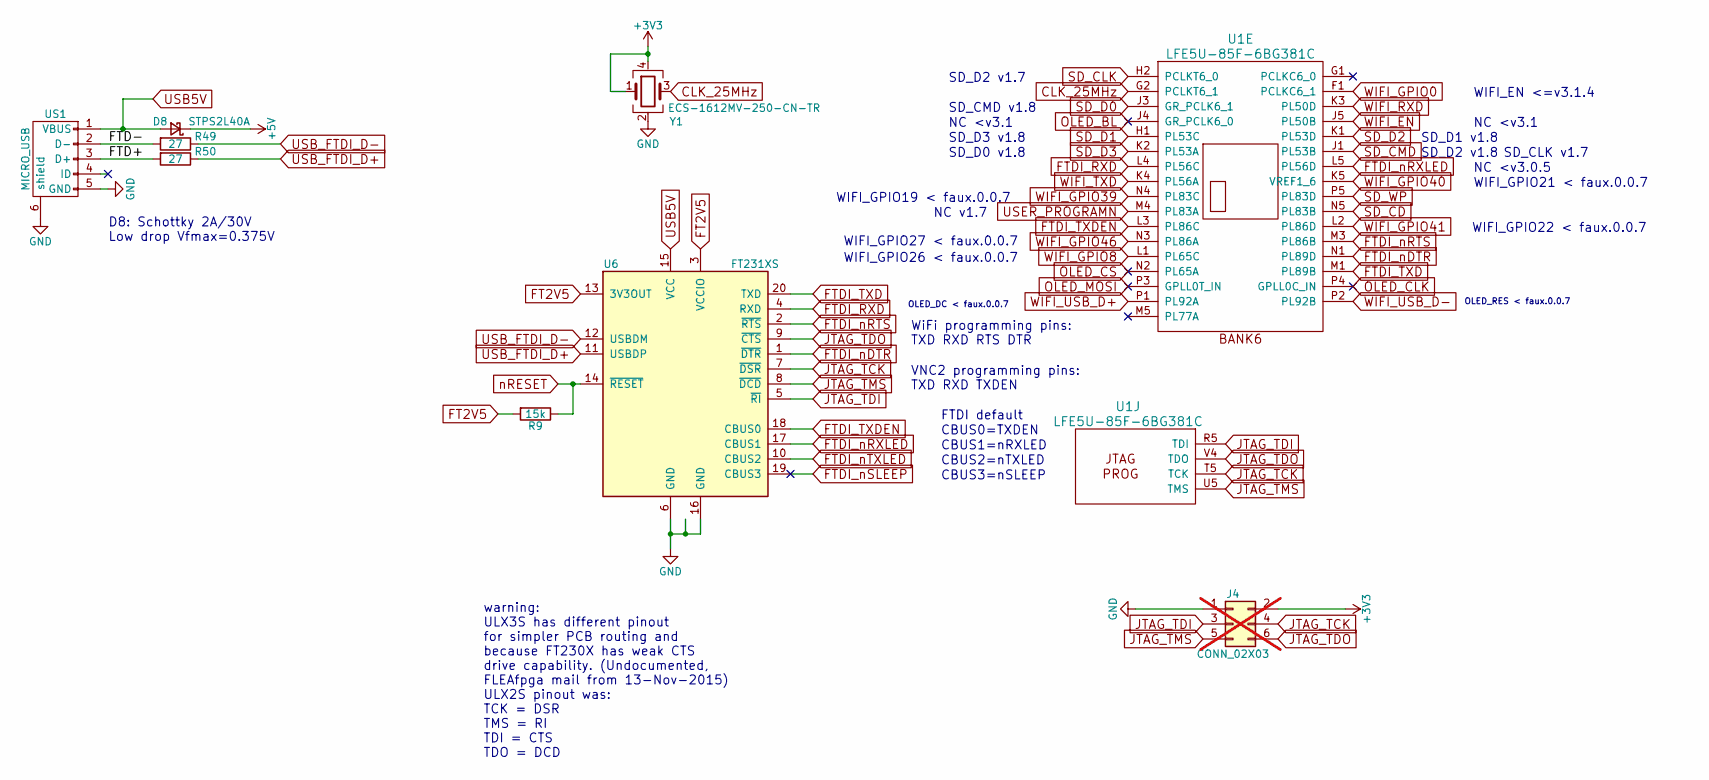
[picture p7: schematic usb.kicad_sch, ULX3S]

Parts:
D8: STPS2L40A; D_SMA; MPN 511-STPS2L30A; Mouser 511-STPS2L40AF
J4: CONN_02X03; PinSocket_2x03_P2.54mm_Vertical; not fitted
R9: 15k; R_0603_1608Metric; MPN RC0603FR-0715KL; Mouser 603-AC0603FR-1015KL
R49: 27; R_0603_1608Metric; MPN AC0603JR-0727RL; Mouser 603-AC0603JR-0727RL
R50: 27; R_0603_1608Metric; MPN AC0603JR-0727RL; LCSC C325726
U1: LFE5U-85F-6BG381C; BGA-381_pitch0.8mm_dia0.4mm; MPN LFE5U-85F-6BG381C; LCSC C446029
U6: FT231XS; FT231X-SSOP-20_4.4x6.5mm_Pitch0.65mm; MPN 895-FT231XS-U; Mouser 895-FT231XQ-R
US1: MICRO_USB; USB-MICRO-B-FCI-10118192-0001LF; MPN 10118192-0001LF; Mouser 649-10118192-0001LF
Y1: ECS-1612MV-250-CN-TR; OSC_ECS-1612MV-250-CN-TR-4; MPN 520-1612MV-250-CNT; Digikey XC2830CT-ND

Connections:
+3V3: J4.2, Y1.1, Y1.4 (VDD); also elsewhere on the board
+5V: D8.1 (K); also elsewhere on the board
/usb/FTD+: R50.2, US1.3 (D+)
/usb/FTD-: R49.2, US1.2 (D-)
AUDIO_L0: U1.E4 (PL17A)
AUDIO_L1: U1.D3 (PL17D)
AUDIO_L3: U1.B3 (PL14D)
AUDIO_R0: U1.A3 (PL14C)
AUDIO_R1: U1.B5 (PL11C)
AUDIO_R2: U1.D5 (PL17B)
AUDIO_R3: U1.C5 (PL11D)
AUDIO_V0: U1.H5 (GR_PCLK7_0)
AUDIO_V1: U1.F2 (PCLKT7_0)
AUDIO_V2: U1.F5 (PL20D)
AUDIO_V3: U1.E5 (PL20C)
BTN_PWRn: U1.D6 (PT6B); also elsewhere on the board
CLK_25MHz: U1.G2 (PCLKT6_1), Y1.3
FT2V5: R9.2, U6.3 (VCCIO), U6.13 (3V3OUT); also elsewhere on the board
FTDI_RXD: U1.L4 (PL56C), U6.4 (RXD)
FTDI_TXD: U1.M1 (PL89B), U6.20 (TXD)
FTDI_TXDEN: U1.L3 (PL86C), U6.18 (CBUS0)
FTDI_nDTR: U1.N1 (PL89D), U6.1 (~DTR)
FTDI_nRTS: U1.M3 (PL86B), U6.2 (~RTS)
FTDI_nRXLED: U1.L5 (PL56D), U6.17 (CBUS1)
FTDI_nSLEEP: U6.19 (CBUS3)
FTDI_nTXLED: U6.10 (CBUS2); also elsewhere on the board
GN0: U1.C11 (PCLKC0_0); also elsewhere on the board
GN1: U1.A11 (PCLKC0_1); also elsewhere on the board
GN2: U1.B10 (GR_PCLK0_0); also elsewhere on the board
GN3: U1.C10 (PT58B); also elsewhere on the board
GN4: U1.A8 (PT18B); also elsewhere on the board
GN5: U1.B8 (PT15B); also elsewhere on the board
GN6: U1.C7 (PT11B)
GN7: U1.B6 (PT4B); also elsewhere on the board
GN8: U1.A5 (PL11B); also elsewhere on the board
GN9: U1.B1 (PL35B); also elsewhere on the board
GN10: U1.B4 (PL14B); also elsewhere on the board
GN11: U1.E3 (PL20B); also elsewhere on the board
GN12: U1.F3 (PCLKC7_1); also elsewhere on the board
GN13: U1.G5 (PL41B); also elsewhere on the board
GND: J4.1, U6.6 (GND), U6.16 (GND), US1.5 (GND), US1.6 (shield), Y1.2 (GND); also elsewhere on the board
GP0: U1.B11 (PCLKT0_0); also elsewhere on the board
GP1: U1.A10 (PCLKT0_1); also elsewhere on the board
GP2: U1.A9 (GR_PCLK0_1); also elsewhere on the board
GP3: U1.B9 (PT58A); also elsewhere on the board
GP4: U1.A7 (PT18A); also elsewhere on the board
GP5: U1.C8 (PT15A); also elsewhere on the board
GP6: U1.C6 (PT11A); also elsewhere on the board
GP7: U1.A6 (PT4A); also elsewhere on the board
GP8: U1.A4 (PL11A); also elsewhere on the board
GP9: U1.A2 (PL35A); also elsewhere on the board
GP10: U1.C4 (PL14A); also elsewhere on the board
GP11: U1.F4 (PL20A); also elsewhere on the board
GP12: U1.G3 (PCLKT7_1); also elsewhere on the board
GP13: U1.H4 (GR_PCLK7_1); also elsewhere on the board
JTAG_TCK: J4.4, U1.T5 (TCK), U6.7 (~DSR); also elsewhere on the board
JTAG_TDI: J4.3, U1.R5 (TDI), U6.5 (~RI); also elsewhere on the board
JTAG_TDO: J4.6, U1.V4 (TDO), U6.9 (~CTS); also elsewhere on the board
JTAG_TMS: J4.5, U1.U5 (TMS), U6.8 (~DCD); also elsewhere on the board
LED0: U1.B2 (VREF1_7); also elsewhere on the board
LED1: U1.C2 (PL35D); also elsewhere on the board
LED3: U1.D2 (PL38C)
LED4: U1.D1 (PL38B)
LED5: U1.E2 (PCLKC7_0)
LED6: U1.E1 (PL38D)
LED7: U1.H3 (PL41D)
OLED_BL: U1.J4 (GR_PCLK6_0)
OLED_CLK: U1.P4 (GPLL0C_IN)
OLED_CS: U1.N2 (PL65A)
OLED_MOSI: U1.P3 (GPLL0T_IN)
SD_CD: U1.N5 (PL83B)
SD_CLK: U1.H2 (PCLKT6_0); also elsewhere on the board
SD_CMD: U1.J1 (PL53B); also elsewhere on the board
SD_D0: U1.J3 (GR_PCLK6_1); also elsewhere on the board
SD_D1: U1.H1 (PL53C); also elsewhere on the board
SD_D2: U1.K1 (PL53D); also elsewhere on the board
SD_D3: U1.K2 (PL53A); also elsewhere on the board
SD_WP: U1.P5 (PL83D)
SW1: U1.E8 (PT13A)
SW2: U1.D8 (PT13B)
SW3: U1.D7 (PT9B)
SW4: U1.E7 (PT9A)
USB5V: D8.2 (A), U6.15 (VCC), US1.1 (VBUS)
USB_FTDI_D+: R50.1, U6.11 (USBDP)
USB_FTDI_D-: R49.1, U6.12 (USBDM)
USER_PROGRAMN: U1.M4 (PL83A); also elsewhere on the board
WIFI_EN: U1.J5 (PL50B); also elsewhere on the board
WIFI_GPIO0: U1.F1 (PCLKC6_1); also elsewhere on the board
WIFI_GPIO3: U1.C1 (PL38A); also elsewhere on the board
WIFI_GPIO8: U1.L1 (PL65C); also elsewhere on the board
WIFI_GPIO9: U1.C3 (PL17C); also elsewhere on the board
WIFI_GPIO38: U1.E6 (PT6A); also elsewhere on the board
WIFI_GPIO39: U1.N4 (PL83C); also elsewhere on the board
WIFI_GPIO40: U1.K5 (VREF1_6); also elsewhere on the board
WIFI_GPIO41: U1.L2 (PL86D); also elsewhere on the board
WIFI_GPIO42: U1.E9 (PT20B); also elsewhere on the board
WIFI_GPIO46: U1.N3 (PL86A); also elsewhere on the board
WIFI_RXD: U1.K3 (PL50D); also elsewhere on the board
WIFI_TXD: U1.K4 (PL56A); also elsewhere on the board
WIFI_USB_D+: U1.P1 (PL92A); also elsewhere on the board
WIFI_USB_D-: U1.P2 (PL92B); also elsewhere on the board
nRESET: R9.1, U6.14 (~RESET)

Notes on the sheet:
WIFI_EN <=v3.1.4
CBUS3=nSLEEP
SD_CLK v1.7
OLED_DC < faux.0.0.7
SD_D0 v1.8
CBUS1=nRXLED
WIFI_GPIO22 < faux.0.0.7
SD_D2 v1.7
NC <v3.1
FTDI default
WIFI_GPIO27 < faux.0.0.7
SD_CMD v1.8
warning: ULX3S has different pinout for simpler PCB routing and because FT230X has weak CTS drive capability. (Undocumented, FLEAfpga mail from 13-Nov-2015) ULX2S pinout was: TCK = DSR TMS = RI TDI = CTS TDO = DCD
OLED_RES < faux.0.0.7
CBUS2=nTXLED
CBUS0=TXDEN
NC v1.7
WiFi programming pins: TXD RXD RTS DTR
NC <v3.0.5
VNC2 programming pins: TXD RXD TXDEN
WIFI_GPIO19 < faux.0.0.7
WIFI_GPIO21 < faux.0.0.7
WIFI_GPIO26 < faux.0.0.7
D8: Schottky 2A/30V Low drop Vfmax=0.375V
SD_D1 v1.8
SD_D3 v1.8
SD_D2 v1.8

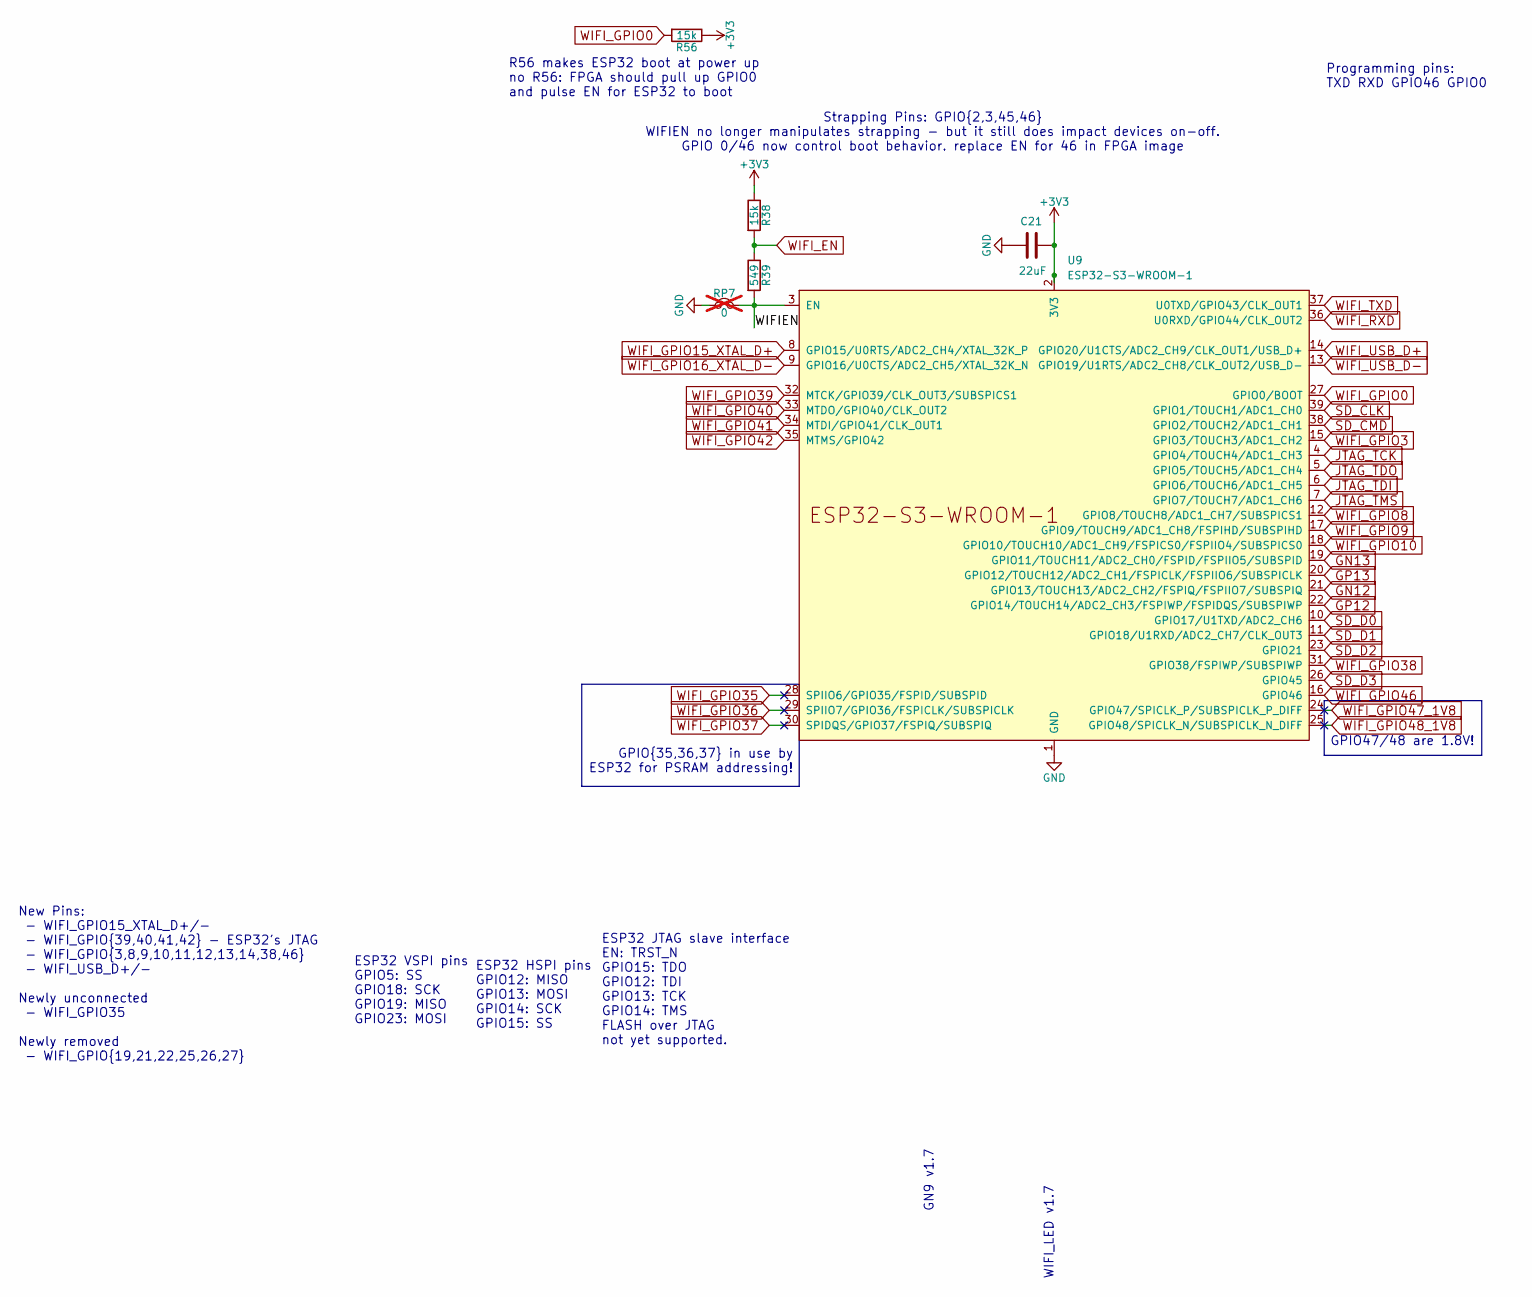
[picture p8: schematic wifi.kicad_sch, ULX3S]

Parts:
C21: 22uF; C_0805_2012Metric; MPN 603-CC805MKX5R6BB226; Digikey 311-1900-1-ND
R38, R56: 15k; R_0603_1608Metric; MPN RC0603FR-0715KL; LCSC C217750
R39: 549; R_0603_1608Metric; MPN 13-AC0603FR-07549RLCT-ND; Digikey 13-AC0603FR-07549RLCT-ND
RP7: 0; R_0805_2012Metric_Pad1.20x1.40mm_HandSolder; MPN 603-RC0805JR-070RL; Mouser_URL www.mouser.com; not fitted
U9: ESP32-S3-WROOM-1; MPN 356-ESP32S3WRM1N16R8; Digikey 5407-ESP32-S3-WROOM-1-N16R8CT-ND

Connections:
+3V3: C21.1, R38.1, R56.1, U9.2 (3V3); also elsewhere on the board
/wifi/WIFIEN: R39.2, RP7.2, U9.3 (EN)
GN12: U9.21 (GPIO13/TOUCH13/ADC2_CH2/FSPIQ/FSPIIO7/S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); also elsewhere on the board
GN13: U9.19 (GPIO11/TOUCH11/ADC2_CH0/FSPID/FSPIIO5/S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); also elsewhere on the board
GND: C21.2, RP7.1, U9.1 (GND), U9.40 (GND), U9.41 (GND); also elsewhere on the board
GP12: U9.22 (GPIO14/TOUCH14/ADC2_CH3/FSPIWP/FSPIDQS/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); also elsewhere on the board
GP13: U9.20 (GPIO12/TOUCH12/ADC2_CH1/FSPICLK/FSPIIO6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); also elsewhere on the board
JTAG_TCK: U9.4 (GPIO4/TOUCH4/ADC1_CH3); also elsewhere on the board
JTAG_TDI: U9.6 (GPIO6/TOUCH6/ADC1_CH5); also elsewhere on the board
JTAG_TDO: U9.5 (GPIO5/TOUCH5/ADC1_CH4); also elsewhere on the board
JTAG_TMS: U9.7 (GPIO7/TOUCH7/ADC1_CH6); also elsewhere on the board
SD_CLK: U9.39 (GPIO1/TOUCH1/ADC1_CH0); also elsewhere on the board
SD_CMD: U9.38 (GPIO2/TOUCH2/ADC1_CH1); also elsewhere on the board
SD_D0: U9.10 (GPIO17/U1TXD/ADC2_CH6); also elsewhere on the board
SD_D1: U9.11 (GPIO18/U1RXD/ADC2_CH7/CLK_OUT3); also elsewhere on the board
SD_D2: U9.23 (GPIO21); also elsewhere on the board
SD_D3: U9.26 (GPIO45); also elsewhere on the board
WIFI_EN: R38.2, R39.1; also elsewhere on the board
WIFI_GPIO0: R56.2, U9.27 (GPIO0/BOOT); also elsewhere on the board
WIFI_GPIO3: U9.15 (GPIO3/TOUCH3/ADC1_CH2); also elsewhere on the board
WIFI_GPIO8: U9.12 (GPIO8/TOUCH8/ADC1_CH7/SUBSPICS1); also elsewhere on the board
WIFI_GPIO9: U9.17 (GPIO9/TOUCH9/ADC1_CH8/FSPIHD/SUBSPIHD); also elsewhere on the board
WIFI_GPIO10: U9.18 (GPIO10/TOUCH10/ADC1_CH9/FSPICS0/FSPIIO4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)
WIFI_GPIO15_XTAL_D+: U9.8 (GPIO15/U0RTS/ADC2_CH4/XTAL_32K_P)
WIFI_GPIO16_XTAL_D-: U9.9 (GPIO16/U0CTS/ADC2_CH5/XTAL_32K_N)
WIFI_GPIO35: U9.28 (SPIIO6/GPIO35/FSPID/SUBSPID)
WIFI_GPIO36: U9.29 (SPIIO7/GPIO36/FSPICLK/SUBSPICLK)
WIFI_GPIO37: U9.30 (SPIDQS/GPIO37/FSPIQ/SUBSPIQ)
WIFI_GPIO38: U9.31 (GPIO38/FSPIWP/SUBSPIWP); also elsewhere on the board
WIFI_GPIO39: U9.32 (MTCK/GPIO39/CLK_OUT3/SUBSPICS1); also elsewhere on the board
WIFI_GPIO40: U9.33 (MTDO/GPIO40/CLK_OUT2); also elsewhere on the board
WIFI_GPIO41: U9.34 (MTDI/GPIO41/CLK_OUT1); also elsewhere on the board
WIFI_GPIO42: U9.35 (MTMS/GPIO42); also elsewhere on the board
WIFI_GPIO46: U9.16 (GPIO46); also elsewhere on the board
WIFI_GPIO47_1V8: U9.24 (GPIO47/SPICLK_P/SUBSPICLK_P_DIFF)
WIFI_GPIO48_1V8: U9.25 (GPIO48/SPICLK_N/SUBSPICLK_N_DIFF)
WIFI_RXD: U9.36 (U0RXD/GPIO44/CLK_OUT2); also elsewhere on the board
WIFI_TXD: U9.37 (U0TXD/GPIO43/CLK_OUT1); also elsewhere on the board
WIFI_USB_D+: U9.14 (GPIO20/U1CTS/ADC2_CH9/CLK_OUT1/USB_D+); also elsewhere on the board
WIFI_USB_D-: U9.13 (GPIO19/U1RTS/ADC2_CH8/CLK_OUT2/USB_D-); also elsewhere on the board

Notes on the sheet:
WIFI_LED v1.7
ESP32 VSPI pins GPIO5: SS GPIO18: SCK GPIO19: MISO GPIO23: MOSI
GN9 v1.7
Programming pins: TXD RXD GPIO46 GPIO0
New Pins: - WIFI_GPIO15_XTAL_D+/- - WIFI_GPIO{39,40,41,42} - ESP32's JTAG - WIFI_GPIO{3,8,9,10,11,12,13,14,38,46} - WIFI_USB_D+/- Newly unconnected - WIFI_GPIO35 Newly removed - WIFI_GPIO{19,21,22,25,26,27}
ESP32 HSPI pins GPIO12: MISO GPIO13: MOSI GPIO14: SCK GPIO15: SS
ESP32 JTAG slave interface EN: TRST_N GPIO15: TDO GPIO12: TDI GPIO13: TCK GPIO14: TMS FLASH over JTAG not yet supported.
Strapping Pins: GPIO{2,3,45,46} WIFIEN no longer manipulates strapping - but it still does impact devices on-off. GPIO 0/46 now control boot behavior. replace EN for 46 in FPGA image
R56 makes ESP32 boot at power up no R56: FPGA should pull up GPIO0 and pulse EN for ESP32 to boot
GPIO47/48 are 1.8V!
GPIO{35,36,37} in use by ESP32 for PSRAM addressing!

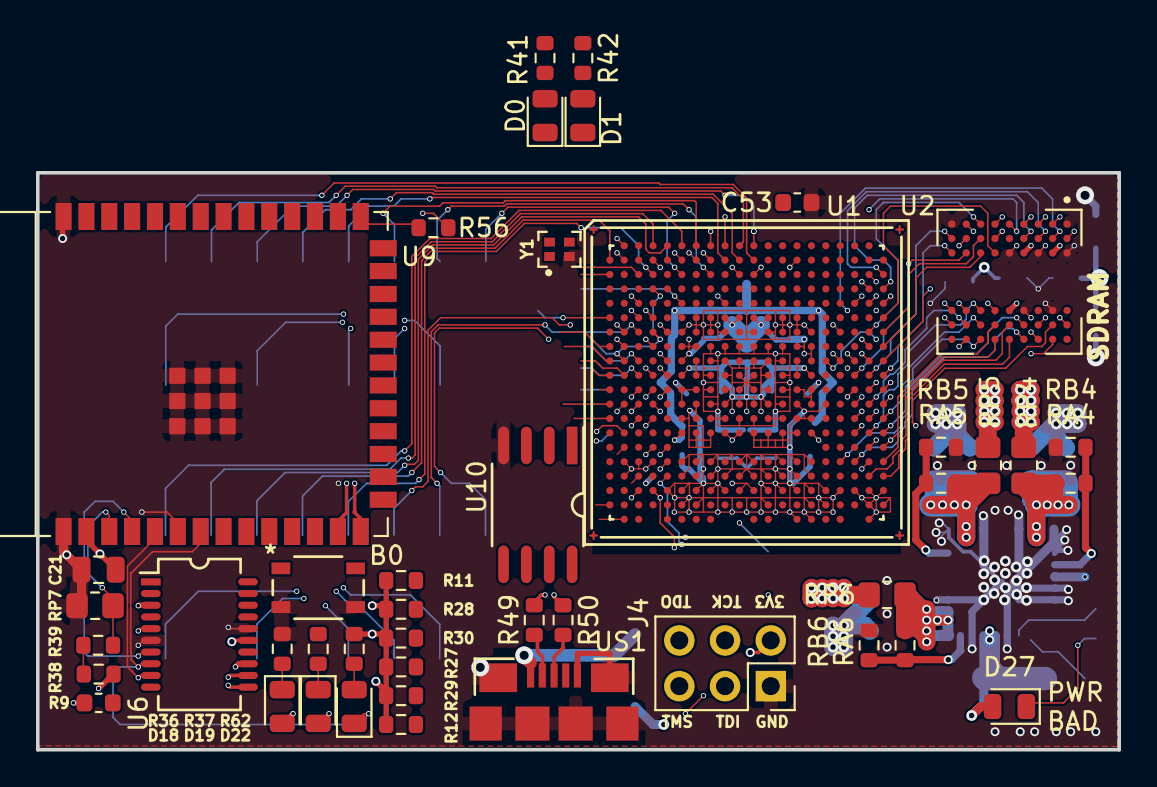
[picture p9: board ulx3s.kicad_pcb from above]

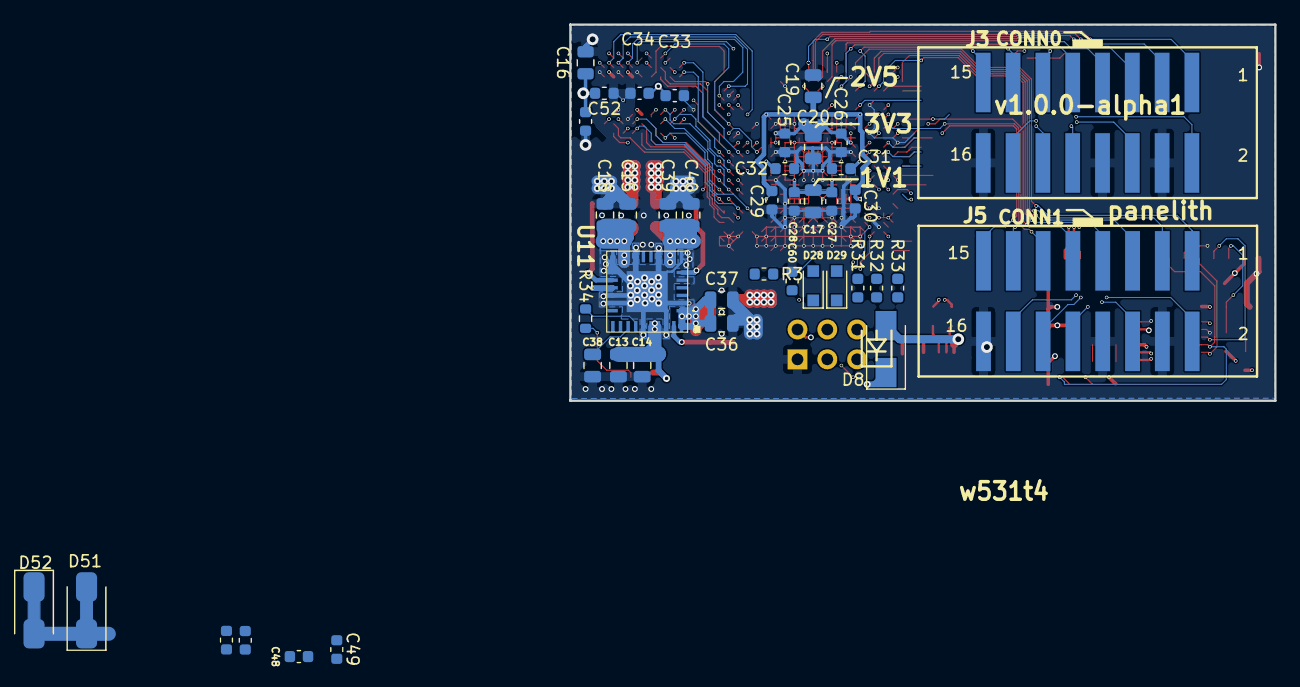
[picture p10: board ulx3s.kicad_pcb from below]

Board: 8 copper layers, 60.1 x 32.0 mm, 87 parts (43 on the bottom side), 141 nets.

Other parts of the board:
D51, D52: 0; D_SMA_Jumper_NC
J3, J5: hub75-abcd; SAMTEC-HTST-108-01-X-DV

Their connections:
+5V: D51.1, D52.2; also elsewhere on the board
GN0: J3.2 (G1); also elsewhere on the board
GN1: J3.5 (R2); also elsewhere on the board
GN2: J3.7 (B2); also elsewhere on the board
GN3: J3.10 (ROW1); also elsewhere on the board
GN4: J3.12 (ROW3); also elsewhere on the board
GN5: J3.14 (RWL); also elsewhere on the board
GN7: J5.2 (G1); also elsewhere on the board
GN8: J5.5 (R2); also elsewhere on the board
GN9: J5.7 (B2); also elsewhere on the board
GN10: J5.10 (ROW1); also elsewhere on the board
GN11: J5.12 (ROW3); also elsewhere on the board
GN12: J5.14 (RWL); also elsewhere on the board
GND: J3.4 (GND), J3.8 (GND), J3.16 (GND), J5.4 (GND), J5.8 (GND), J5.16 (GND); also elsewhere on the board
GP0: J3.1 (R1); also elsewhere on the board
GP1: J3.3 (B1); also elsewhere on the board
GP2: J3.6 (G2); also elsewhere on the board
GP3: J3.9 (ROW0); also elsewhere on the board
GP4: J3.11 (ROW2); also elsewhere on the board
GP5: J3.13 (PXC); also elsewhere on the board
GP6: J3.15 (nOE); also elsewhere on the board
GP7: J5.1 (R1); also elsewhere on the board
GP8: J5.3 (B1); also elsewhere on the board
GP9: J5.6 (G2); also elsewhere on the board
GP10: J5.9 (ROW0); also elsewhere on the board
GP11: J5.11 (ROW2); also elsewhere on the board
GP12: J5.13 (PXC); also elsewhere on the board
GP13: J5.15 (nOE); also elsewhere on the board
