w531t4/panelith/(commit log)

2026-04-30 convert old kicad to 9
    [analog.kicad_sch, blinkey.kicad_sch, flash.kicad_sch, gpdi.kicad_sch, gpio.kicad_sch, power.kicad_sch, ram.kicad_sch, serdes.kicad_sch]
2026-04-30 update pcb from schematic
2026-04-30 upgrade lib esp32
2026-04-30 added PWR_PIN to analog ADC_3.3v
    [analog.kicad_sch, flash.kicad_sch, gpdi.kicad_sch, gpio.kicad_sch, power.kicad_sch, ram.kicad_sch, serdes.kicad_sch, usb.kicad_sch]
2026-04-30 fix: incorrect pin types for max1112x
    [analog.kicad_sch]
2026-04-30 omit .bak files from footprints dir
2026-04-30 add PWR_PIN to RTCVDD
    [power.kicad_sch]
2026-04-30 add pwr_pin to 2.5v
    [power.kicad_sch]
2026-04-30 add pwr_pin to 1.1v
    [power.kicad_sch]
2026-04-30 add pwr_pin to 5v
    [power.kicad_sch]
2026-04-30 add pwr_flag to VREF2
    [gpdi.kicad_sch]
2026-04-30 add pwr_flag to SD3V3
    [wifi.kicad_sch]
2026-04-30 add pwr_flag to +3V3
    [power.kicad_sch]
2026-04-30 update ref-/ref+ pins to passive (erc) max11125
    [analog.kicad_sch]
2026-04-30 update pin4 on usb-micro connector to passive
    [usb.kicad_sch]
2026-04-30 mark DOUT/CSOn as not-connected
    [flash.kicad_sch]
2026-04-30 fix: broken crystal pinout after github: 5286
    [usb.kicad_sch]
2026-04-30 make PT20A no-connect
    [gpio.kicad_sch]
2026-04-30 make GR_PCLK1_0 no-connect
    [gpdi.kicad_sch]
2026-04-30 update directionality of some fgpa pins
    [ram.kicad_sch, usb.kicad_sch]
2026-04-30 push schematic changes to pcb
2026-05-01 allow bridged solder mask aperatures between pads within footprints
2026-05-01 Remove old project files
    [analog.sch, blinkey.sch, flash.sch, gpdi.sch, gpio.sch, power.sch, ram.sch, serdes.sch]
2026-05-01 reposition resistor to avoid drc error
2026-05-01 fix: only one connection to mounting hole near esp32 on bottom,u2
2026-05-01 add empty lib socket_strips
2026-05-01 save end-connectors to socket_strips. update footprint in schematic, push schem to pcb
2026-05-01 use .3mm border around thermal-relief square edge connector pads
2026-05-01 add via to provide gnd to isolated island on j3
2026-05-01 modify d21 pad 2 to allow for additional thermal relief track
2026-05-01 Remove exlusion zone to assist C56/C55's ground pads get an extra relief leg
2026-05-01 reposition C30 so that D20 pinA can get another thermal relief leg
2026-05-01 remove an exclusion zone to assist c25/c26 get to another thermal relief leg
2026-05-01 remove unconnected track
2026-05-01 re-run usb_fpga_d- do use individual traces
2026-05-01 fix footprint for LCD1 (pad4)
2026-05-01 add mounting_holes local lib
2026-05-01 copy footprint to local repo
2026-05-02 remove unneeded components from schema
    [analog.kicad_sch, blinkey.kicad_sch, flash.kicad_sch, gpdi.kicad_sch, gpio.kicad_sch, power.kicad_sch, ram.kicad_sch, usb.kicad_sch]
2026-05-02 immediately after - update pcb from schematic
2026-05-02 remove a few more oled things
    [serdes.kicad_sch]
2026-05-02 resolve errors
    [ulx3s.kicad_pcb]
2026-05-02 update constraints, don't apply them yet
    [ulx3s.kicad_pcb]
2026-05-02 ignore kicad prl
2026-05-02 update track widths, begin routing paths
    [ulx3s.kicad_pcb]
2026-05-02 rewire all the things
    [ulx3s.kicad_pcb]
2026-05-02 remove btn_r, clean trace/via
    [ram.kicad_sch, ulx3s.kicad_pcb]
2026-05-02 mark other button as no-connect, remove tracks
    [ram.kicad_sch, ulx3s.kicad_pcb]
2026-05-02 moving more wires
    [ulx3s.kicad_pcb]
2026-05-02 update silkscreen
    [ulx3s.kicad_pcb]
2026-05-02 start to normalize bom
    [blinkey.kicad_sch, flash.kicad_sch, gpdi.kicad_sch, gpio.kicad_sch, power.kicad_sch, ram.kicad_sch, serdes.kicad_sch, ulx3s.kicad_sch]
2026-05-02 updating part numbers across schematcs
    [backup_fpga.kicad_sch, blinkey.kicad_sch, flash.kicad_sch, power.kicad_sch, ram.kicad_sch, serdes.kicad_sch, ulx3s.kicad_sch, usb.kicad_sch]
2026-05-02 switched from STPS2L30AF to STPS2L30A
    [usb.kicad_sch]
2026-05-02 migrate ram from MT48LC16M16A2TG-6A to IS42S16160J-6TL
    [ram.kicad_sch, ulx3s.kicad_pcb]
2026-05-02 update mouser PN for 4.8kresistor
    [flash.kicad_sch, power.kicad_sch, ulx3s.kicad_pcb]
2026-05-02 update mpn at mouser/digikey for 2N7002
    [power.kicad_sch, ulx3s.kicad_pcb]
2026-05-02 switch from NSR0530HT1G to BAT54WSQ-7-F
    [power.kicad_sch, ulx3s.kicad_pcb]
2026-05-02 adjust mouser part number of BC857 to 757-TBC857BLM
    [power.kicad_sch, ulx3s.kicad_pcb]
2026-05-02 switch to FT231XS (not Q) - rewire for SSOP-20
    [ulx3s.kicad_pcb, usb.kicad_sch]
2026-05-03 initial s3 stuff
    [esp32_s3_wifi.kicad_sch, ulx3s.kicad_pcb, ulx3s.kicad_sch, wifi.kicad_sch]
2026-05-03 upgrade to kicad10
    [analog.kicad_sch, backup_fpga.kicad_sch, blinkey.kicad_sch, esp32_s3_wifi.kicad_sch, flash.kicad_sch, gpdi.kicad_sch, gpio.kicad_sch, power.kicad_sch]
2026-05-03 update datasheet for ram
    [ram.kicad_sch]
2026-05-03 update url to ftdi datasheet
    [usb.kicad_sch]
2026-05-03 fix footprint/symbol for ft231- need to re-work routing
    [ulx3s.kicad_pcb, usb.kicad_sch]
2026-05-03 add colors to JTAG/FTDI nets
    [ulx3s.kicad_pcb]
2026-05-03 mark all extra pins as no-connect. erc fixed.
    [backup_fpga.kicad_sch, esp32_s3_wifi.kicad_sch]
2026-05-03 remove 433mhz ant
    [ulx3s.kicad_pcb, usb.kicad_sch]
2026-05-03 rewire of ft231 complete
    [ulx3s.kicad_pcb]
2026-05-03 set more reasonable copper->edge. fix 3v3 pin not-attached. fix overlayed via
    [ulx3s.kicad_pcb]
2026-05-04 remove a few unused pins
    [ram.kicad_sch, ulx3s.kicad_pcb]
2026-05-04 update track for usb. reposition ftdi
    [ulx3s.kicad_pcb]
2026-05-04 add rules for differential pair USB
    [ulx3s.kicad_pcb]
2026-05-04 add rules for sdram skew
    [ulx3s.kicad_pcb]
2026-05-04 add some more netclasses
    [ulx3s.kicad_pcb]
2026-05-04 rewire J1 bus. move buttons up. move some more voltage stuff to In1.cu
    [ulx3s.kicad_pcb]
2026-05-04 reposition led's
    [ulx3s.kicad_pcb]
2026-05-04 reposition flash
    [ulx3s.kicad_pcb]
2026-05-04 make a few via's larger
    [ulx3s.kicad_pcb]
2026-05-04 reposition f1/f2 buttons
    [ulx3s.kicad_pcb]
2026-05-05 rework esp area again, due to incorrect footprint. add some netclass rules. put esp32 and ftdi on front of board
    [esp32_s3_wifi.kicad_sch, wifi.kicad_sch]
2026-05-05 add corner holes to paste layer for stencil alignment
2026-05-05 use substitution with page attributes for silkscreen
2026-05-05 still use extra stencil paste hole, but use through-hole marker again
2026-05-06 move 3 led's to front of board
2026-05-06 0.0.6 - fix footprint of four circles
2026-05-07 Remove 'Leave Empty' in favor of using attributes
    [flash.kicad_sch, gpio.kicad_sch, power.kicad_sch, ulx3s.kicad_sch, usb.kicad_sch, wifi.kicad_sch]
2026-05-07 add web bom for 0.0.6
2026-05-07 remove wake up/shutdown logic
    [blinkey.kicad_sch, power.kicad_sch, usb.kicad_sch]
2026-05-07 add 0ohm resistor to bom for RV3
    [power.kicad_sch, ulx3s.kicad_sch]
2026-05-07 removed optional 2.5 on J1
    [gpio.kicad_sch, power.kicad_sch]
2026-05-07 remove analog schematic
    [analog.kicad_sch, ulx3s.kicad_sch]
2026-05-07 remove buttons f1/f2
    [blinkey.kicad_sch, flash.kicad_sch, ulx3s.kicad_pcb]
2026-05-07 remove hanging track
    [ulx3s.kicad_pcb]
2026-05-07 reposition clock to top of board
    [ulx3s.kicad_pcb]
2026-05-07 reposition 3v3 lines around flash resistors/IC
    [ulx3s.kicad_pcb]
2026-05-07 remove extra 3v3 bar. extend rule area to cover j1
    [ulx3s.kicad_pcb]
2026-05-08 remove ref. to 2.5v on rear silkscreen
    [ulx3s.kicad_pcb]
2026-05-09 add courtyard to bga381
    [ulx3s.kicad_pcb]
2026-05-09 update schematic with new footprint for ram. pre-wiring the ram on pcb
    [ram.kicad_sch, ulx3s.kicad_pcb]
2026-05-10 route wires to BGA SDRAM
2026-05-10 add MPM54304 to symbol/footprints
2026-05-10 replace psu symbol for new device... haven't yet pushed to pcb
    [power.kicad_sch]
2026-05-10 fixed missing PxVx nets
    [power.kicad_sch]
2026-05-11 replaced psu, need to still to drc
    [power.kicad_sch, ram.kicad_sch]
2026-05-11 remaining thing: i2c connector
    [gpio.kicad_sch, power.kicad_sch]
2026-05-11 close off i2c, too fragile
    [power.kicad_sch]
2026-05-11 update parts for 22uf/1uf. Update footprint for RP* items
    [backup_fpga.kicad_sch, blinkey.kicad_sch, esp32_s3_wifi.kicad_sch, flash.kicad_sch, gpdi.kicad_sch, gpio.kicad_sch, power.kicad_sch, ram.kicad_sch]
2026-05-12 move memory closer to fpga
    [flash.kicad_sch]
2026-05-12 interim esp32 change
    [backup_fpga.kicad_sch, power.kicad_sch, wifi.kicad_sch]
2026-05-12 remove extra schematic page for esp32
    [esp32_s3_wifi.kicad_sch, ulx3s.kicad_sch]
2026-05-13 reposition flash to bottom. route esp32-s3. fix drc issues
    [gpio.kicad_sch, ulx3s.kicad_sch, usb.kicad_sch, wifi.kicad_sch]
2026-05-13 add silkscreen border around power chip
2026-05-13 remove serdes. fix led connectivity issues
    [serdes.kicad_sch]
2026-05-21 add hub75 connector to libraries
2026-05-21 update footprint for hub75
2026-05-21 remove legacy esp32 from schematic
    [wifi.kicad_sch]
2026-05-21 remove US2 port
    [gpdi.kicad_sch, usb.kicad_sch]
2026-05-22 remove extra sheet for alt fpga
    [backup_fpga.kicad_sch, ulx3s.kicad_sch]
2026-05-22 switch to new oscillator
    [usb.kicad_sch]
2026-05-22 add footprint for smaller pts810 button
2026-05-22 switch to smaller pts810 button
    [power.kicad_sch]
2026-05-23 add some comment labels to power plane nets
2026-05-23 broken: shrink board, re-orient parts. mid-progress, before 4-6 layer
    [gpio.kicad_sch, ulx3s.kicad_sch]
2026-05-23 reassign j1 signals
    [gpio.kicad_sch, ulx3s.kicad_pcb]
2026-05-24 in progress, placement happend -- working on wiring
    [blinkey.kicad_sch, flash.kicad_sch, gpdi.kicad_sch, gpio.kicad_sch, power.kicad_sch, ram.kicad_sch, serdes.kicad_sch, ulx3s.kicad_pcb]
2026-05-24 attempting to route memory, moved to 8layer
    [ulx3s.kicad_pcb]
2026-05-24 memory is wired
    [ulx3s.kicad_pcb]
2026-05-24 routed conn1
    [ulx3s.kicad_pcb]
2026-05-25 finished routing conn1/conn2
    [ulx3s.kicad_pcb]
2026-05-25 routed power
    [ulx3s.kicad_pcb]
2026-05-25 routed jtag, partial ftdi
    [ulx3s.kicad_pcb]
2026-05-26 done with routing
    [gpio.kicad_sch, power.kicad_sch, ram.kicad_sch, usb.kicad_sch, wifi.kicad_sch]
2026-05-26 done with drc
    [ram.kicad_sch]
2026-05-26 bump board to panelith v1.0.1
2026-05-26 move to v1.0.2 - use 0.09mm default trace
    [ulx3s.kicad_sch]
2026-05-26 update board stackup
    [ulx3s.kicad_sch]
2026-05-26 fix diff pairs
    [usb.kicad_sch, wifi.kicad_sch]
2026-05-26 add i2c header
    [power.kicad_sch, ram.kicad_sch]
2026-05-27 fix drc for differential traces
2026-05-27 switch to usb-c. upgrade to v1.0.4
    [gpio.kicad_sch, power.kicad_sch, usb.kicad_sch]
2026-05-27 add fids, add attributions on board, bump to v1.0.5
    [bom.csv, designators.csv, positions.csv, ulx3s.kicad_sch, usb.kicad_sch]
2026-05-27 this should have gone with the prev. commit
    [ulx3s.csv, usb.kicad_sch]
2026-05-27 make MPN reflect mouser part numbers
    [blinkey.kicad_sch, flash.kicad_sch, gpdi.kicad_sch, gpio.kicad_sch, power.kicad_sch, ram.kicad_sch, serdes.kicad_sch, usb.kicad_sch]
2026-06-02 add ground to i2c header
    [power.kicad_sch]
2026-06-04 add secondary power-only usb-c connector. v1.0.9
    [power.kicad_sch, usb.kicad_sch]
2026-06-04 v1.0.10 - changed wire slop to copper polygons
2026-06-04 update footprints to include additional border. add i2c resistors
    [flash.kicad_sch, gpdi.kicad_sch, gpio.kicad_sch, power.kicad_sch, ram.kicad_sch, serdes.kicad_sch, usb.kicad_sch]
2026-06-05 update shematic for new hub75 connector
    [gpio.kicad_sch]
2026-06-05 fix board after move to new hub75 connector
2026-06-05 switch to pinheader for jtag in schematic
    [usb.kicad_sch]
2026-06-05 Switch to TagConnect for JTAG
    [usb.kicad_sch]
2026-06-05 update bom fields
    [blinkey.kicad_sch, flash.kicad_sch, gpdi.kicad_sch, gpio.kicad_sch, power.kicad_sch, ram.kicad_sch, serdes.kicad_sch, ulx3s.kicad_sch]
2026-06-05 remove extra unnecessary symbol from hub75 footprint on rrear side
2026-06-05 don't populate 3pin i2c header
    [power.kicad_sch]
2026-06-05 attach 3d design to footprint
2026-06-05 update part numbers for us2
    [usb.kicad_sch]
2026-06-06 shift hub75 closer together, move and replace button
    [power.kicad_sch]
2026-06-07 add mounting holes. reposition ft231x. use nsleep
    [blinkey.kicad_sch, ulx3s.kicad_sch, usb.kicad_sch]
2026-06-07 fix proximity of gnd
2026-06-07 avoid via placement in cap/resistor gap
2026-06-07 manually use arcs in edge.cut. update half-hole footprint. remove cu x's from fpga footprint
2026-06-07 reposition usr led's to bottom
2026-06-07 fix schematic parity
2026-06-07 remove extra label from silkscreen
2026-06-07 v1.0.14 - respect 0.5mm max POVF via size. fix type of button.
    [positions.csv]
2026-06-09 reposition holes near pmic
2026-06-09 v1.0.16 - switch via type. fix j/h issue.
    [positions.csv]
2026-06-22 remove stale stuff from repo
    [1-click-bom.tsv, ECP5UM25Pinout.csv, ECP5UM45Pinout.csv, ECP5UM5G-25Pinout.csv, ECP5UM5G-45Pinout.csv, ECP5UM5G-85Pinout.csv, ECP5UM85Pinout.csv, bom-ulx3s-v1.7.6.csv]
2026-06-22 remove schematics symlink
2026-06-22 v1.0.17 - fix power layer v3.3 issue. readjust fpga zones so vias are fully covered
    [blinkey.kicad_sch, flash.kicad_sch, gpdi.kicad_sch, gpio.kicad_sch, panelith.csv, panelith.kicad_sch, power.kicad_sch, ram.kicad_sch]
